Noah4730/Senior-Design/Design Package/Schematics/Arduino Mega 2560 Pinout Projects & Spec_External.png

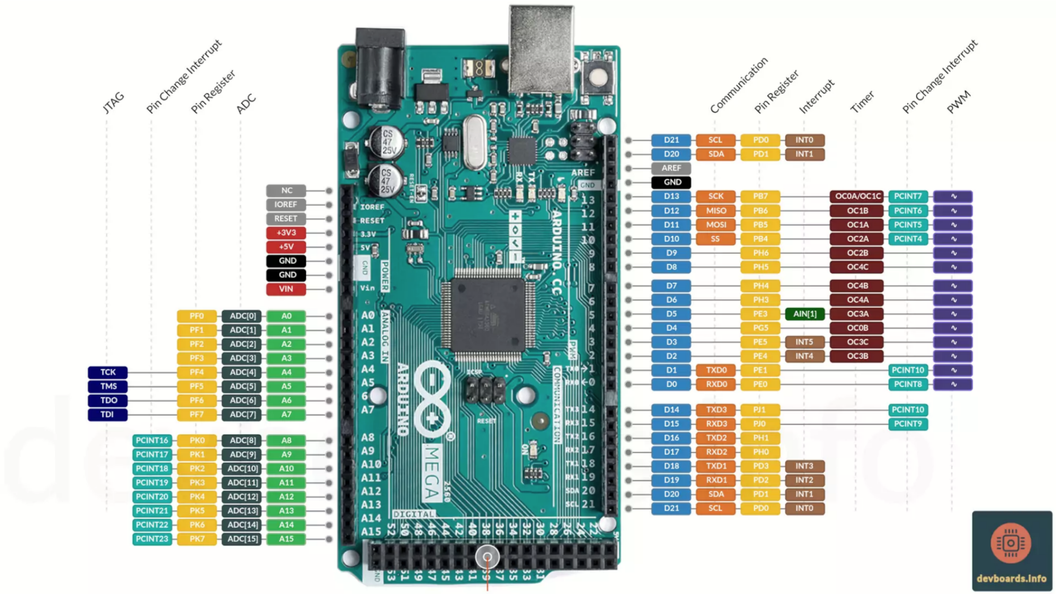
Design Package/Schematics/Arduino Mega 2560 Pinout Projects & Spec_External.png
