Noah4730/Senior-Design/Design Package/Schematics/Optocoupler Image_External.jpg

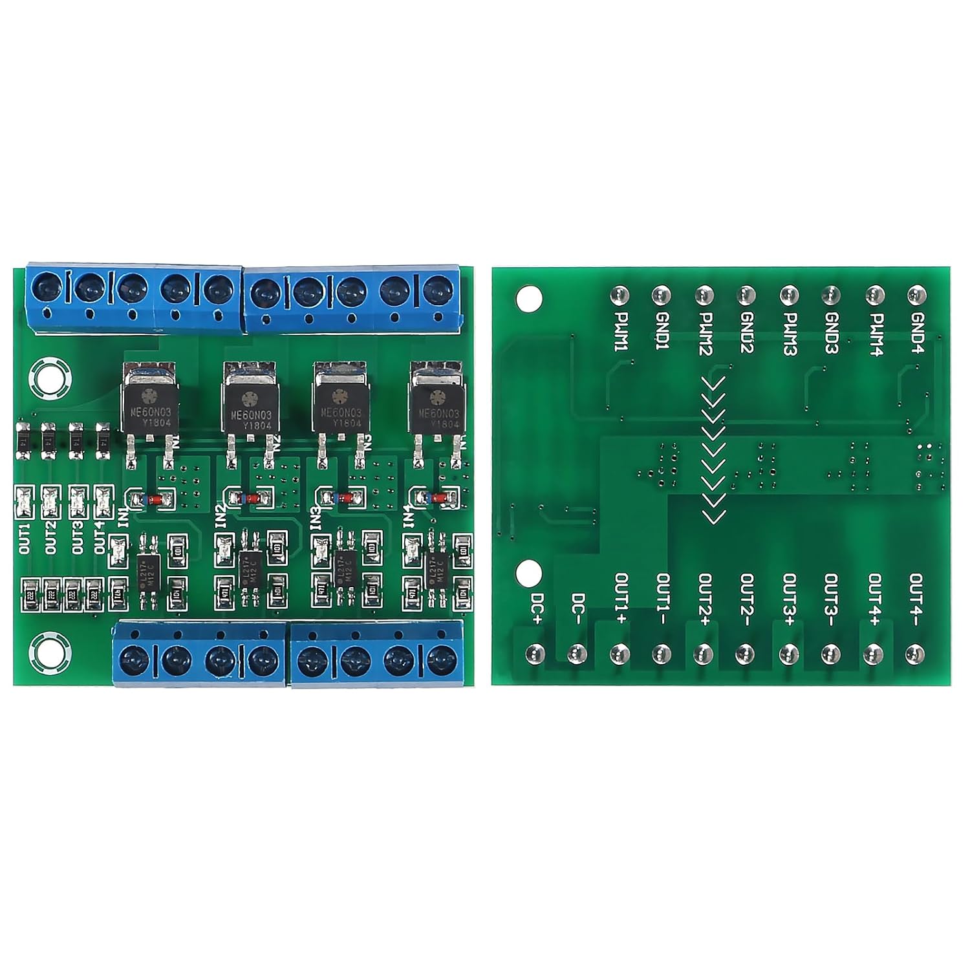
Design Package/Schematics/Optocoupler Image_External.jpg
