Noah4730/Senior-Design/README.md

# Senior-Design
This Github project contains the progress on the Zeus Project. As of May 2026, the team has created a concept demo of how the device will function as proof of concept and find any problems we might have while making the prototype.
