Noah4730/Senior-Design/Misc LRAD info/YouTube Links of stuff I found.docx

YouTube Links of stuff I found

This guy created a DIY LRAD device and… it’s very large to say the least. He has some files in the description:

https://youtu.be/y7UZHEHhdek (https://youtu.be/y7UZHEHhdek?si=uDVMpo0iQYFFn_xV)

The same guy is showing how to defend yourself against them:

https://youtu.be/Lg_aUOSLuRo (https://youtu.be/Lg_aUOSLuRo?si=JcSFuqxDgXy68F-K)

A YouTube short of this guy who made an LRAD out of stuff from Walmart:

https://youtu.be/MhGSYTc4Fus (https://youtu.be/MhGSYTc4Fus?si=M1YSCUhVt2ILN-A1)
