Noah4730/Senior-Design/Design Package/CAD Drawings/Self_Defense_Device_lights_DC.pdf

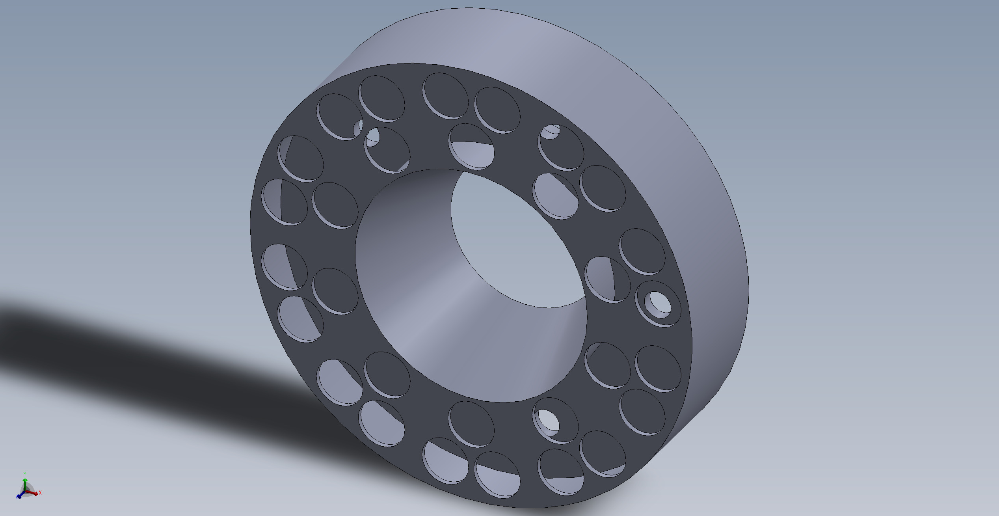
[picture p34: page 1]
