Noah4730/Senior-Design/Design Package/CAD Drawings/Concept Drawing 2_NJS.jpg

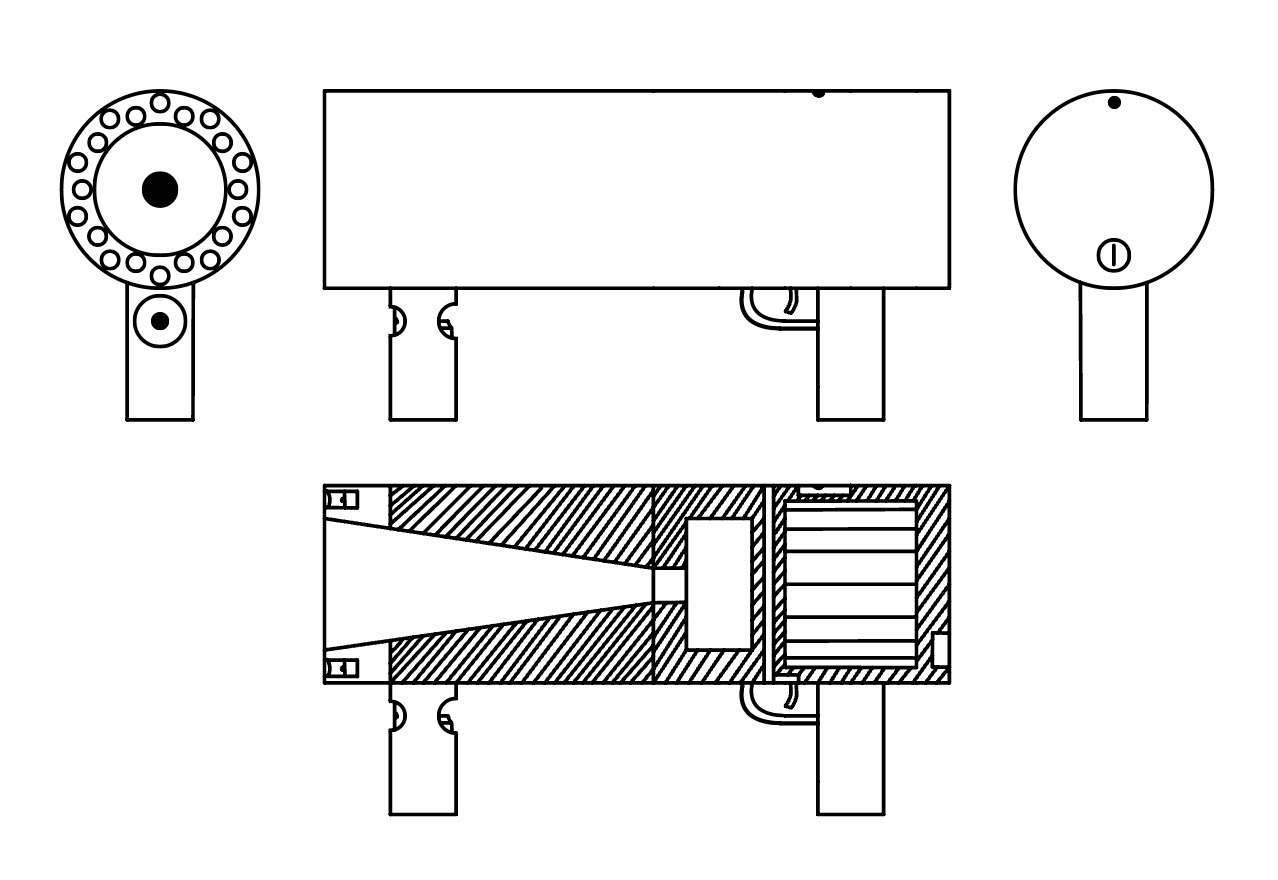
Design Package/CAD Drawings/Concept Drawing 2_NJS.jpg
