Noah4730/Senior-Design/Design Package/Schematics/LED Sim Draft_JA.png

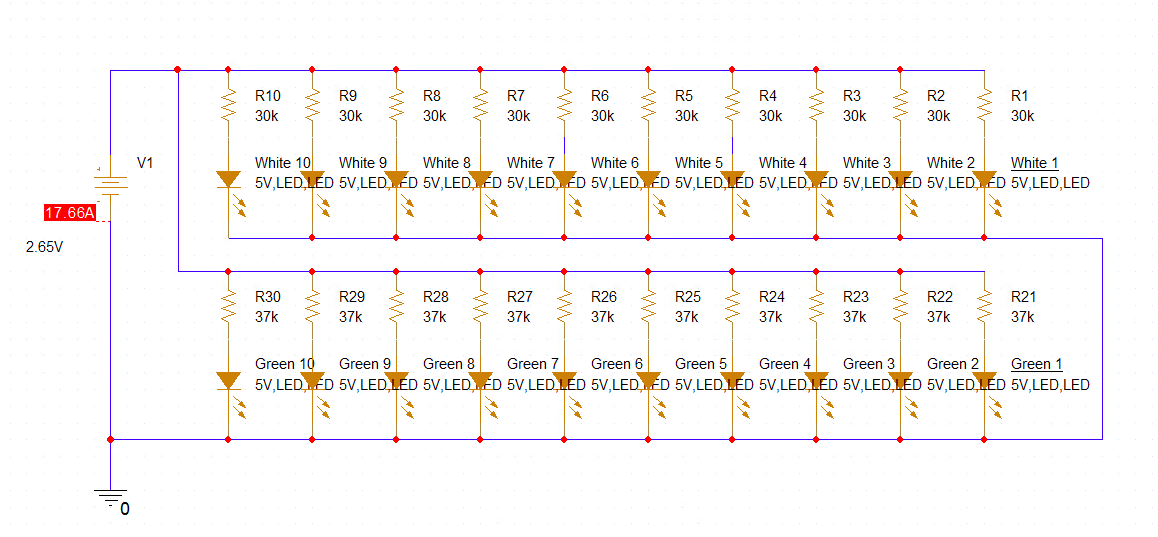
Design Package/Schematics/LED Sim Draft_JA.png
