Noah4730/Senior-Design/Design Package/Schematics/Optocoupler Pinout_External.jpg

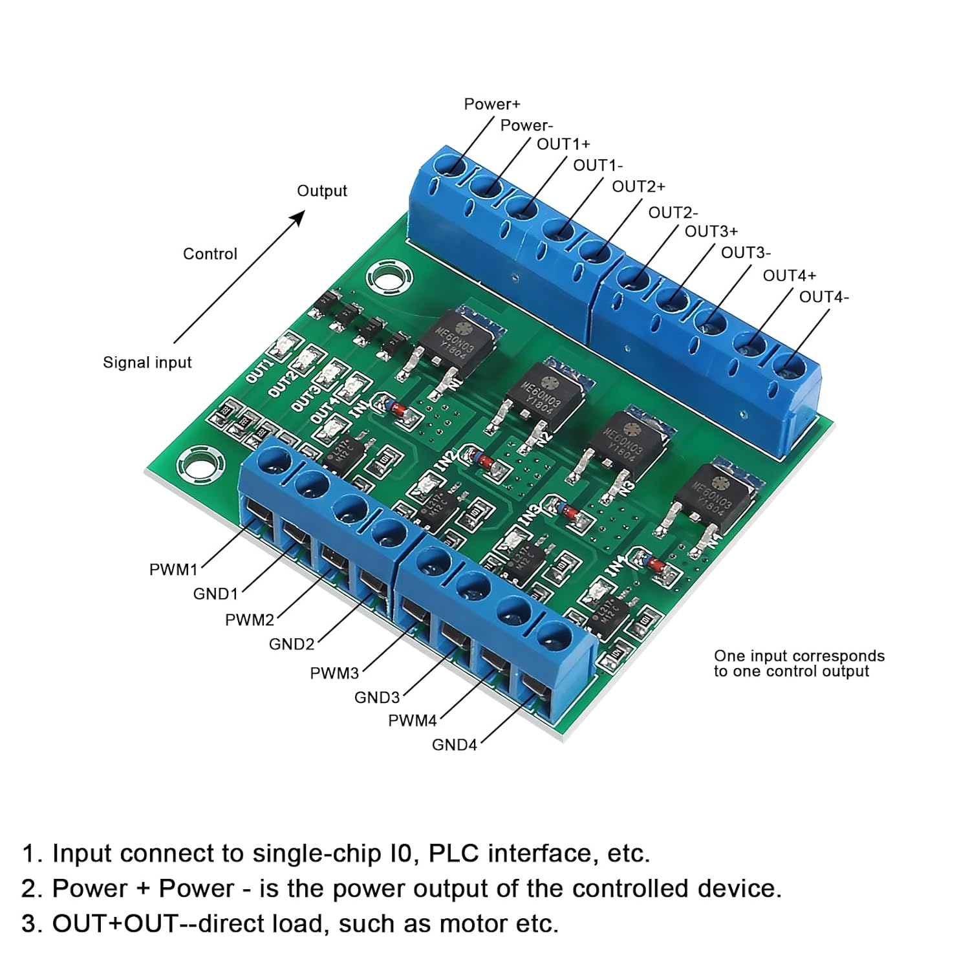
Design Package/Schematics/Optocoupler Pinout_External.jpg
