Noah4730/Senior-Design/Hardware Diagram.png

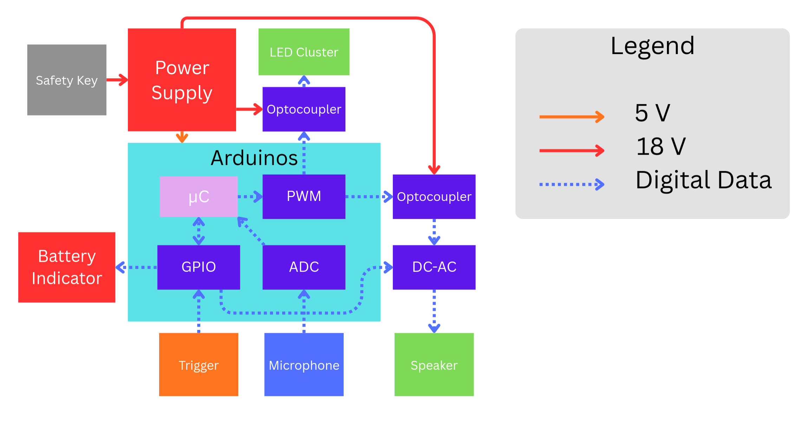
Hardware Diagram.png
