Noah4730/Senior-Design/Senior Design Project_JA.gif

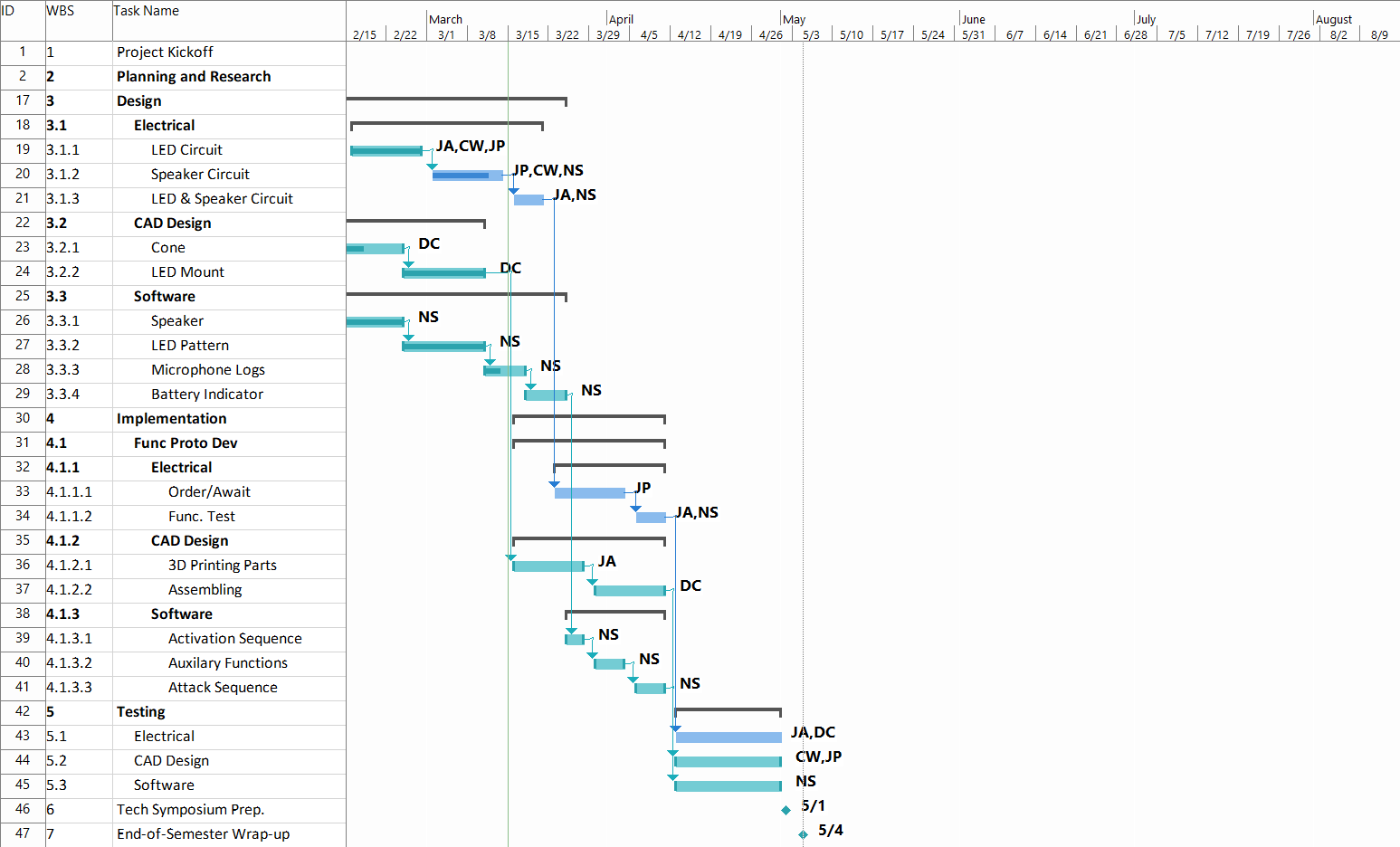
Senior Design Project_JA.gif
