Noah4730/Senior-Design/Design Package/Components/Working Project Inventory_JP.xlsx

Item Name | Manufacturer | Model No. | pkgs | amt in pkg | Notes | Provided by | Column 8
Green LED Star | CREEXPE2-GRN or ce20grnr3 | g20-s4 2551 | 1 | 10 | $10, total 102.80 or 20 of them grw1 | Bret | We actually use
"" Cool White XLAMP Cree XML2 | CREEXML2-W318 | ido-u3 2602 | 2 | 8 | 2pkgs ,8 $10.58 total 96.99, 10 119.89 | Bret | We actually use
LED Lens 5 degree | - | - | 1 | 10 | 20mm High Power | Bret | We actually use
LED Lens 15 degree | - | - | 1 | 10 | 20mm High Power | Bret | We actually use
Lens 5 degree | - | - | 1 | 10 | 20mm High Power Clear | Bret | We actually use
LED Convex Lens | - | - | 1 | 20 | Lamp Beads | Bret | We actually use
Speaker | DS18Pro | Pro-DRNSC1.5 |  |  | 1.5" polymide Voice Coil Screw 320W peak power , driver w neodymium magnet , throat 1"/25.4mm we like it loud | Bret | We actually use
Electrical Wire | Haerkn | - | 3 | 1 | - | Bret | We actually use
ESP32 WROOM Dev Board | AiTrip | 15363 | 1 | 1 | 300 pin | Ourselves | We actually use
DC Step Up Converter | KTOPTENG | I0015-A149 | 1 | 1 | 12/24V-36V 6A 216W Step Up Car Power Supply Converter Regulator Waterproof | Ourselves | We actually use
Light-dimming Film | - | - |  |  | Protect eyes from LEDs | Professors | We actually use
Lumen Meter | - | - |  |  | Measure light output | Professors | We actually use
2.5x10mm Metal Inserts | - | - | 1 | 10 | Use as connectors for device | Professors | We actually use
Rectifier Diode | Bojack | IN5408 | 1 | 50 | BJ-08 V(RRM) 1kV I(AV) 3A | Bret | We do not use
Midrange/Tweeter Compression Driver | Pyle USA | PDS122 | 2 | 1 | 250W 1.4" 35mm Flat Aluminum Voice Coil 1.5k-20kHz, | Bret | We do not use
LED Flasher Fn | Everbright |  | 4 | 4 | - | Bret | We do not use
Sound Level Meter dB | Durfiost | SL720C | 1 | 1 | - | Bret | We do not use
Car Relay | - | JD2912 | 2 | 2 | 12V 4Pin 20A ...an Motorcycle, boat 40A 14VDC 86 87 30 | Bret | We do not use
DMWD Metal Halo Ring | - | - | 5 | 5 | 12mm Metal ..th Halo Ring Blue LED | Bret | We do not use
Self-Fusing Silicone Tape | Proxicast | ANT-900-002 | 1 | 1 | Pro-Grade Great for Sealing COAX Connectors 1.5inx30milx15ft | Bret | We do not use
Dual Sided M-F HEader Connector | Sunxeke | - | 2 | 2 | 17 Values Double Sided | Bret | We do not use
Mini fan | - | A251012M |  |  | sleere bearing DC12v 0.06A | Bret | We do not use
Voltage Regulator Assortment Kit | Bojack | - | 1 | 50 | 10 values 50pcs LM317T...L7824 | Bret | We do not use
Laser Scope | feyachi | - |  |  | Laser Sight Module armed forces | Bret | We do not use
trigger switches | nilight | - | 1 | 6 | - | Bret | We do not use
Mace Pepper gel | - | Magnum 3 |  |  | Distance defense 10% oc pepper invisible uvdye gel stream | Bret | We do not use
Low Thermal Resistence Adhesive | Arctic Silver | ASTA-20G | 1 | 1 | Reach/rohs compliant, luxeonstar.com/asta-20g, Quick cure silver epoxy permanent thermal adhesive | Bret | We do not use
WigWagger Alternating Flasher | Stop Alert | - | 2 | 1 | 72, 36wx2/12-24V | Bret | We do not use
55 Lithium Battery Board 20A | - | - | 1 | 1 | - | Bret | We do not use
Step Down Module | HiLetgo, Shenzehenshi | - | 1 | 1 | 5A 75W DC-DC Step down module | Bret | We do not use
Metal Universal Driver Speaker | Speco technologies | SRD100 | 1 | 1 | 100W RMS 16Ohm VC 1-3/8"x18TPI Throat | Bret | We do not use
Cooling Fan | GDSTIME | - | 2 | 2 | 2pk 80mmx25mm Dual Ball Bearings High Speed 4500RPM 12VDC Brushless COoling Fan | Bret | We do not use
Motorcycle Voltage Monitor | Exqutoo | - | 1 | 2 | DC 0-100V | Bret | We do not use
Battery Packs (Drones) | R-Line | - | 3 | 1 | Tattu Lipo R-Line3.0 1550mAh 120C 5 cells 18.5V 28.6Wh | Bret | We do not use
Smart Charger | Lipo | 608PD | 1 | 1 | ISD Link, PD 3.1 DC input 240w, USBc input 140W isdt.co | Bret | We do not use
Silicone PVC Wire | TUOFENG | - | 3 | 1 | 22AWG 100ft 2pin 1pack | Bret | We do not use
Lipo Battery Voltage Tester | CAMWAY | CAM001s | 1 | 1 | 5pcs 2 in 1 1-8s Lipo/Li-ion/LiMn/LiFe | Bret | We do not use
Power Amplifier | HiLetgo | TPA3116 | 1 | 1 | 2pcs | Bret | We do not use
