Noah4730/Senior-Design/Design Package/CAD Drawings/Light_Assembly_V2_DC.SLDPRT

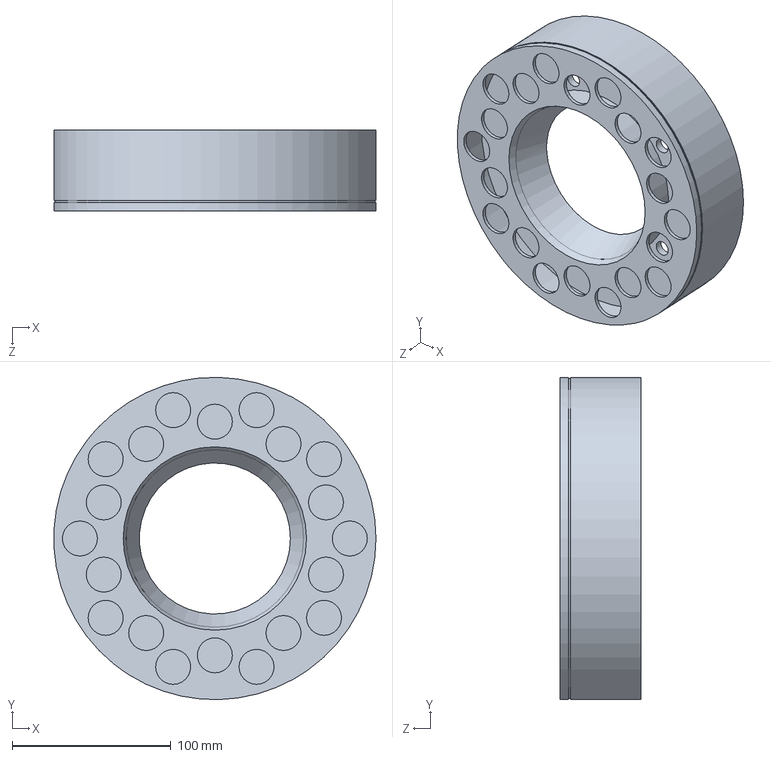
[picture p42: CAD file, 2026-09-04]
Design Package/CAD Drawings/Light_Assembly_V2_DC.SLDPRT
203.0 x 203.1 x 50.8 mm
