Noah4730/Senior-Design/Design Package/CAD Drawings/BodyDeviceTemp.stl

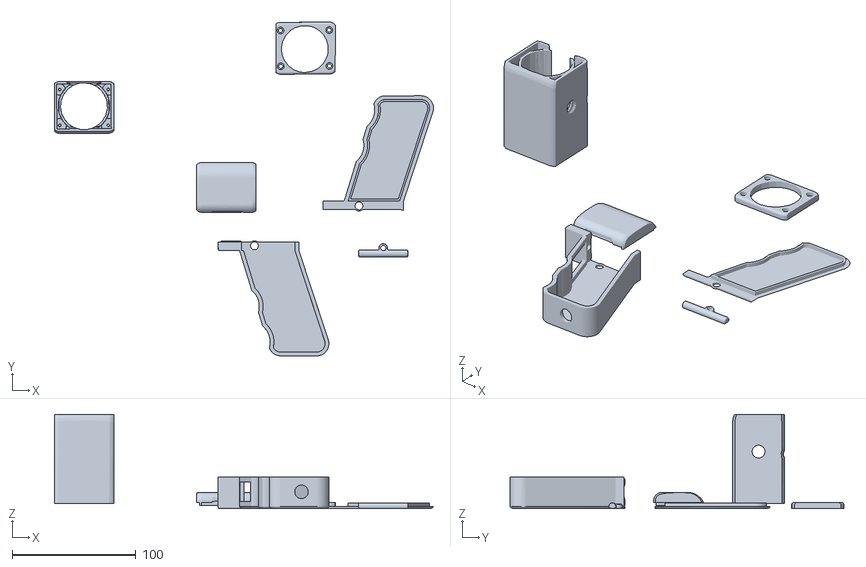
[picture p43: CAD file, 2026-09-25]
Design Package/CAD Drawings/BodyDeviceTemp.stl
306.1 x 269.7 x 76.0
