Noah4730/Senior-Design/LED_BACK_FINAL.SLDPRT

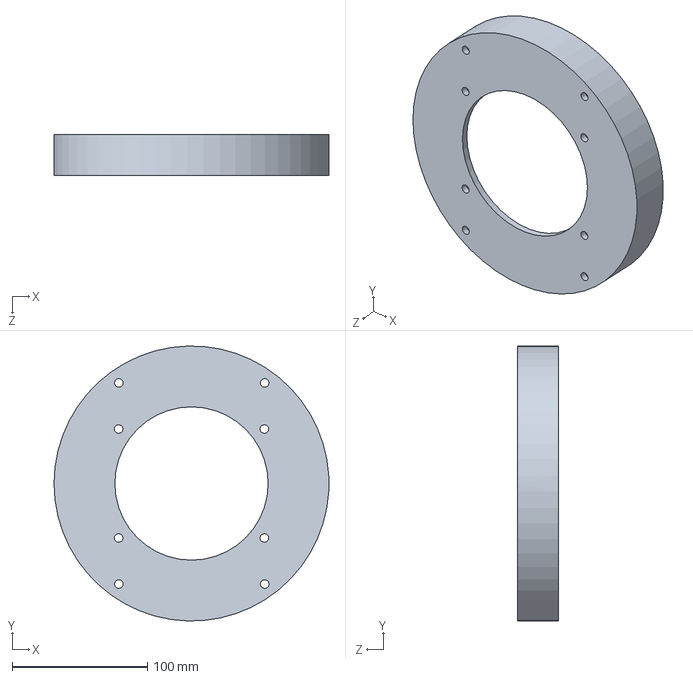
[picture p44: CAD file, 2026-11-02]
LED_BACK_FINAL.SLDPRT
203.2 x 203.1 x 30.5 mm
