Noah4730/Senior-Design/Design Package/CAD Drawings/Cone_V2_DC.SLDPRT

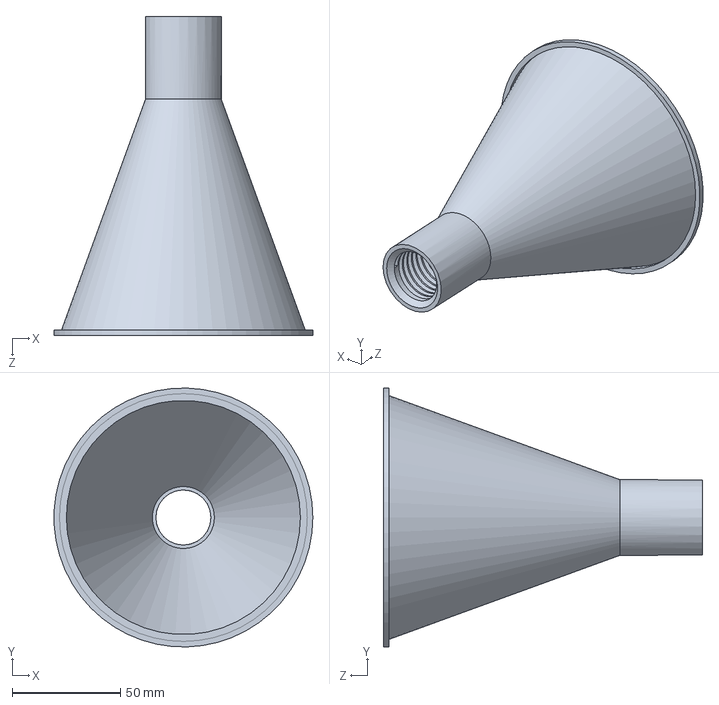
[picture p45: CAD file, 2026-09-10]
Design Package/CAD Drawings/Cone_V2_DC.SLDPRT
119.3 x 119.3 x 147.1 mm
