Noah4730/Senior-Design/LED_FACE_FINAL.SLDPRT

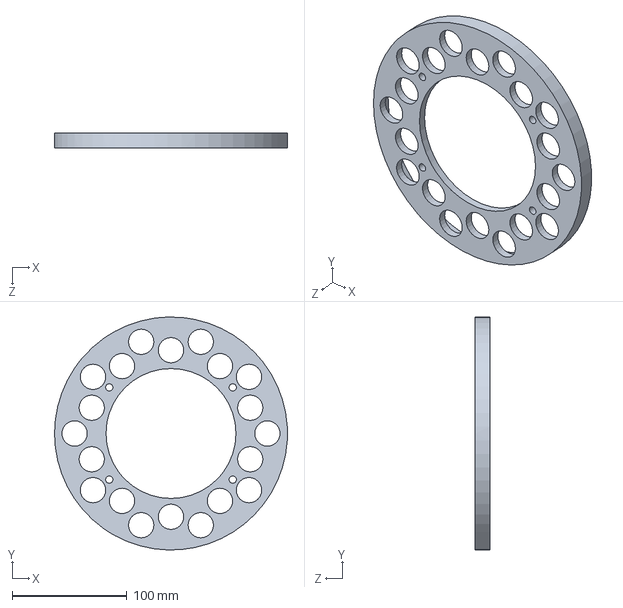
[picture p46: CAD file, 2026-11-02]
LED_FACE_FINAL.SLDPRT
203.2 x 203.1 x 12.7 mm
