Noah4730/Senior-Design/Cone_FINAL.SLDPRT

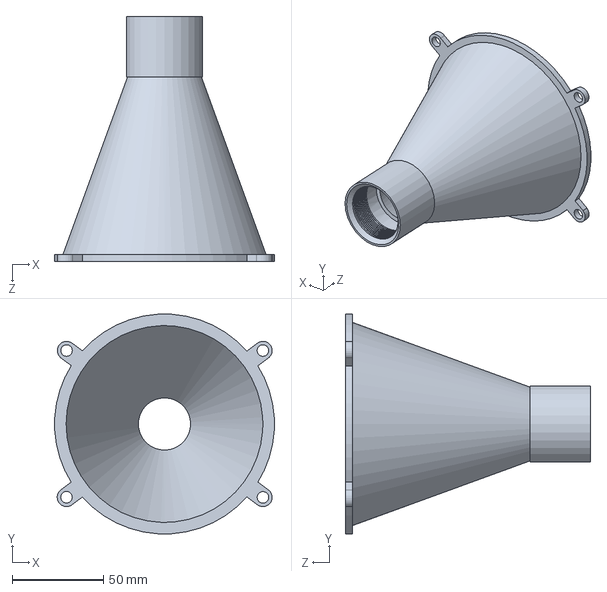
[picture p47: CAD file, 2026-11-02]
Cone_FINAL.SLDPRT
120.6 x 120.6 x 134.4 mm
