Noah4730/Senior-Design/Design Package/CAD Drawings/Self_Defense_Device_lights_DC.SLDPRT

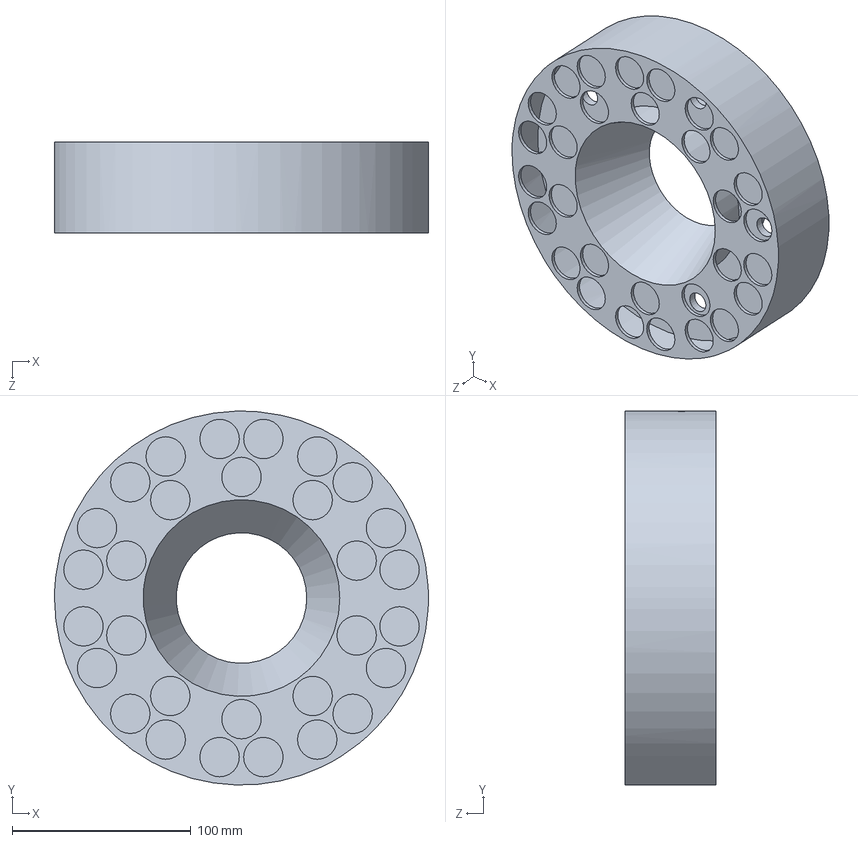
[picture p48: CAD file, 2026-09-04]
Design Package/CAD Drawings/Self_Defense_Device_lights_DC.SLDPRT
209.2 x 209.2 x 50.8 mm
