Noah4730/Senior-Design/(list of files, cad)

Other CAD files:
Design Package/CAD Drawings/Cone_V1_DC.SLDPRT
CONE_V3_DIMENSION1.SLDDRW
CONE_V3_DIMENSION2.SLDDRW
LED_BACKDIMENSION1.SLDDRW
LED_BACKDIMENSION2.SLDDRW
LED_FACEDIMENSION2.SLDDRW
LED_FACE_DIMENSION1.SLDDRW
