Noah4730/Senior-Design/Test Spreadsheets/TestCases_JP.xlsx

Sheet: Template_1.1
Project Name |  | Project Zeus |  | Module Name |  | Integration Verification
Created By |  | Jessy Pena |  | Created Date |  | 2026-10-02
Executed By |  |  |  | Execution Date
Reviewed By |  |  |  | Reviewed Date
Test Scenario ID |  | ITV_001
Test Scenario Description |  | Test trigger activates and deactivates device properly and immediately
Test Case ID |  | ITV_Trigger_001
Test Case Description |  | User pulls trigger to its full extent, and releases fully
Test Case Results |  | (Pass/Fail/Not executed/Suspended/Further Review)
 | Prerequisites |  |  |  | Test Data
1 | Device needs to have all components connected |  |  | 1 | Pull trigger completely and hold for 10 seconds continuously
2 | User must be able to wield device and pull/release trigger |  |  | 2 | Release trigger fully after 10s
3 | User must be wearing hearing PPE |  |  | 3
4 |  |  |  | 4
Step # | Step Details |  | Expected Results |  |  | Actual Results | Status
1 | Hold device similar to a gun, hand on grip and finger off trigger |  | No sound or lights should be on
2 | Insert & turn safety key to on position |  | Activates safety light
3 | Press trigger fully down and hold for 10s |  | Sound and light should occur, in expected, randomized intervals
4 | Release trigger fully after 10s |  | Sound and light should cease, and safety light should reactivate
5
6
7
8
9
10
11

Sheet: Template_1.2
Project Name |  | Zeus |  | Module Name |  | Integration Verification
Created By |  | Jessy Pena |  | Created Date |  | 2026-10-02
Executed By |  |  |  | Execution Date
Reviewed By |  |  |  | Reviewed Date
Test Scenario ID |  | ITV_001
Test Scenario Description |  | Test trigger activates and deactivates device properly and immediately
Test Case ID |  | ITV_Trigger_002
Test Case Description |  | User pulls trigger to its full extent, and releases halfway
Test Case Results |  | (Pass/Fail/Not executed/Suspended/Further Review)
 | Prerequisites |  |  |  | Test Data
1 | Device needs to have all components connected |  |  | 1 | Pull trigger completely and hold for 10 seconds continuously
2 | User must be able to wield device and pull/release trigger |  |  | 2 | Release trigger to half position after 10s
3 | User must be wearing hearing PPE |  |  | 3
4 |  |  |  | 4
Step # | Step Details |  | Expected Results |  |  | Actual Results | Status
1 | Hold device similar to a gun, hand on grip and finger off trigger |  | No sound or lights should be on
2 | Insert & turn safety key to on position |  | Activates safety light
3 | Press trigger fully down and hold 10s |  | Sound and light should occur, in expected, randomized intervals
4 | Release trigger to halfway position |  | Sound and light should cease, and safety light should reactivate
5
6
7
8
9
10
11

Sheet: Template_1.3
Project Name |  | Zeus |  | Module Name |  | Integration Verification
Created By |  | Jessy Pena |  | Created Date |  | 2026-10-02
Executed By |  |  |  | Execution Date
Reviewed By |  |  |  | Reviewed Date
Test Scenario ID |  | ITV_001
Test Scenario Description |  | Test trigger activates and deactivates device properly and immediately
Test Case ID |  | ITV_Trigger_003
Test Case Description |  | User pulls trigger halfway, and releases fully
Test Case Results |  | (Pass/Fail/Not executed/Suspended/Further Review)
 | Prerequisites |  |  |  | Test Data
1 | Device needs to have all components connected |  |  | 1 | Pull trigger to halfway position and hold for 10 seconds continuously
2 | User must be able to wield device and pull/release trigger |  |  | 2 | Release trigger fully after 10s
3 | User must be wearing hearing PPE |  |  | 3
4 |  |  |  | 4
Step # | Step Details |  | Expected Results |  |  | Actual Results | Status
1 | Hold device similar to a gun, hand on grip and finger off trigger |  | No sound or lights should be on
2 | Insert & turn safety key to on position |  | Activates safety light
3 | Press trigger halfway and hold for 10s |  | Sound and light should not occur, safety light should still be on
4 | Release trigger fully |  | Sound and light should not occur, safety light should still be on
5
6
7
8
9
10
11

Sheet: Template_2.1
Project Name |  | Zeus |  | Module Name |  | Integration Verification
Created By |  | Jessy Pena |  | Created Date |  | 2026-10-02
Executed By |  |  |  | Execution Date
Reviewed By |  |  |  | Reviewed Date
Test Scenario ID |  | ITV_003
Test Scenario Description |  | Verifies safety key enables and disables trigger function
Test Case ID |  | ITV_SafetyKey_001
Test Case Description |  | User turns safety key to on position and pulls trigger completely
Test Case Results |  | (Pass/Fail/Not executed/Suspended/Further Review)
 | Prerequisites |  |  |  | Test Data
1 | Device needs to have all components connected |  |  | 1 | User inserts key and turns to on position
2 | User must be able to wield device and pull/release trigger |  |  | 2
3 | User must be wearing hearing PPE |  |  | 3
4 | User must have key to insert |  |  | 4
Step # | Step Details |  | Expected Results |  |  | Actual Results | Status
1 | Hold device similar to a gun, hand on grip and finger off trigger |  | No sound or lights should be on
2 | Insert & turn safety key to on position |  | Safety light should be active, power should be on
3 | Press trigger fully down and release after 10s |  | Sound and light should occur, in expected, randomized intervals, then end immediately after release
4
5
6
7
8
9
10
11

Sheet: Template_2.2
Project Name |  | Zeus |  | Module Name |  | Integration Verification
Created By |  | Jessy Pena |  | Created Date |  | 2026-10-02
Executed By |  |  |  | Execution Date
Reviewed By |  |  |  | Reviewed Date
Test Scenario ID |  | ITV_003
Test Scenario Description |  | Verifies safety key enables and disables trigger function
Test Case ID |  | ITV_SafetyKey_002
Test Case Description |  | User does not turn safety key to on position and pulls trigger completely
Test Case Results |  | (Pass/Fail/Not executed/Suspended/Further Review)
 | Prerequisites |  |  |  | Test Data
1 | Device needs to have all components connected |  |  | 1 | User inserts key but does not turn on
2 | User must be able to wield device and pull/release trigger |  |  | 2 | User pulls trigger fully and releases after 10s
3 | User must be wearing hearing PPE |  |  | 3
4 | User must have key to insert |  |  | 4
Step # | Step Details |  | Expected Results |  |  | Actual Results | Status
1 | Hold device similar to a gun, hand on grip and finger off trigger |  | No sound or lights should be on
2 | Insert safety key but do not turn on |  | No sound or lights should be on, all power still off
3 | Press trigger fully down and release after 10s |  | Sound and light should still be off, with no change from previous actions
4
5
6
7
8
9
10
11

Sheet: Template_3.1
Project Name |  | Zeus Project |  | Module Name |  | Integration Verification
Created By |  | Jessy Pena |  | Created Date |  | 2026-10-02
Executed By |  |  |  | Execution Date
Reviewed By |  |  |  | Reviewed Date
Test Scenario ID |  | SLV_007
Test Scenario Description |  | Verifies battery indicator displays accurate charge and low battery warning
Test Case ID |  | SLV_BatteryInd_001
Test Case Description |  | Battery is fully charged
Test Case Results |  | (Pass/Fail/Not executed/Suspended/Further Review)
 | Prerequisites |  |  |  | Test Data
1 | Battery, monitoring circuit, microcontroller with software, indicator are needed to be connected properly |  |  | 1 | Power on, battery at certain voltage
2 | Multimeter to measure voltage |  |  | 2
3 |  |  |  | 3
4 |  |  |  | 4
Step # | Step Details |  | Expected Results |  |  | Actual Results | Status
1 | Connect all components according to schematic |  | Power should be flowing, battery indicator should not be on
2 | Press on button of microcontroller |  | Battery indicator should be on and displaying a full charge battery, no warning
3 | Connect multimeter in parallel with battery |  | Multimeter should display the voltage the battery is outputting
4 | Connect multimeter in parallel with battery indicator |  | Multimeter should display the voltage the battery is outputting
5
6
7
8
9
10
11

Sheet: Template_3.2
Project Name |  | Zeus Project |  | Module Name |  | Integration Verification
Created By |  | Jessy Pena |  | Created Date |  | 2026-10-02
Executed By |  |  |  | Execution Date
Reviewed By |  |  |  | Reviewed Date
Test Scenario ID |  | SLV_007
Test Scenario Description |  | Verifies battery indicator displays accurate charge and low battery warning
Test Case ID |  | SLV_BatteryInd_002
Test Case Description |  | Battery is at 20% or less
Test Case Results |  | (Pass/Fail/Not executed/Suspended/Further Review)
 | Prerequisites |  |  |  | Test Data
1 | Battery, monitoring circuit, microcontroller with software, indicator are needed to be connected properly |  |  | 1 | Power on, battery at certain voltage
2 | Multimeter to measure voltage |  |  | 2
3 |  |  |  | 3
4 |  |  |  | 4
Step # | Step Details |  | Expected Results |  |  | Actual Results | Status
1 | Connect all components according to schematic |  | Power should be flowing, battery indicator should not be on
2 | Press on button of microcontroller |  | Battery indicator should be on and displaying a low-battery warning
3 | Connect multimeter in parallel with battery |  | Multimeter should display the voltage the battery is outputting (≤20%)
4 | Connect multimeter in parallel with battery indicator |  | Multimeter should display the voltage the battery is outputting (≤20%)
5
6
7
8
9
10
11

Sheet: ExampleA
Project Name |  | mySoftwareProject |  | Module Name |  | myLogin
Created By |  | Johnathan Votion |  | Created Date |  | 2022-09-09
Executed By |  | TeamMember |  | Execution Date |  | ThisDate
Reviewed By |  |  |  | Reviewed Date
Test Scenario ID |  | TS_MLG_001
Test Scenario Description |  | Test user login credentials and verify functionality
Test Case ID |  | TC_MLG_Login_001
Test Case Description |  | User enters valid user name and valid password
Test Case Results |  | (Pass/Fail/Not executed/Suspended/Further Review)
 | Prerequisites |  |  |  | Test Data
1 | System needs to have test data registered into the system/network. |  |  | 1 | Username: myname@gmail.com
2 | There needs to be an available URL. Dafsafaasf |  |  | 2 | password: xxxxx
3 | URL w/ username and password fields. |  |  | 3
4 | URL w/ login button. |  |  | 4
Step # | Step Details |  | Expected Results |  |  | Actual Results | Status
1 | Enter username information into username field |  | Username information appears in username field. |  |  | As Expected | Pass
2 | Enter password information into password field |  | Password information appears in password field as asterisks or black dots. |  |  | Password field does not mask password characters | Fail
3 | Click on the login button |  | Browser advances to homepage |  |  | As Expected | Pass
4
5
6
7
8
9
10

Sheet: ExampleB
Project Name |  | Zeus |  | Module Name |  | myLogin
Created By |  | Johnathan Votion |  | Created Date |  | 2022-09-09
Executed By |  | TeamMember |  | Execution Date |  | ThisDate
Reviewed By |  |  |  | Reviewed Date
Test Scenario ID |  | TS_MLG_001
Test Scenario Description |  | Test User login credentials and verify functionality
Test Case ID |  | TC_MLG_Login_002
Test Case Description |  | Enter valid user name and invalid password
Test Case Results |  | (Pass/Fail/Not executed/Suspended/Further Review)
 | Prerequisites |  |  |  | Test Data
1 | System needs to have test data registered into the sytstem/network. |  |  | 1 | Username: myname@gmail.com
2 | There needs to be an available URL. Dafsafaasf |  |  | 2 | password: yyyyyyy
3 |  |  |  | 3
4 |  |  |  | 4
Step # | Step Details |  | Expected Results |  |  | Actual Results | Status
1 | Enter username information into username field |  | Username information appears in username field. |  |  | As Expected | Pass
2 | Enter password information into password field |  | Password information appears in password field as asterisks or black dots. |  |  | As Expected | Pass
3 | Click on the login button |  | Browser gives message "Incorrect Login" |  |  | Browser gives blank message | Fail
4
5
6
7
8
9
10
