Noah4730/Senior-Design/Test Spreadsheets/Test Cases_SVV-03_SLV-01-03_NJS.xlsx

Sheet: Template
Project Name |  |  |  | Module Name
Created By |  |  |  | Created Date
Executed By |  |  |  | Execution Date
Reviewed By |  |  |  | Reviewed Date
Test Scenario ID
Test Scenario Description
Test Case ID
Test Case Description
Test Case Results |  | (Pass/Fail/Not executed/Suspended/Further Review)
 | Prerequisites |  |  |  | Test Data
1 |  |  |  | 1
2 |  |  |  | 2
3 |  |  |  | 3
4 |  |  |  | 4
Step # | Step Details |  | Expected Results |  |  | Actual Results | Status
1
2
3
4
5
6
7
8
9
10
11

Sheet: SSV-03
Project Name |  | Self-Defense Device (Zeus) |  | Module Name |  | Subsystem Verification
Created By |  | Noah Schatz |  | Created Date |  | 2026-10-02
Executed By |  |  |  | Execution Date
Reviewed By |  |  |  | Reviewed Date
Test Scenario ID |  | SSV-03
Test Scenario Description |  | Microcontroller & MOSFET Test
Test Case ID |  | SSV-03
Test Case Description |  | Verify the functionality of the microcontroller and MOSFETs.
Test Case Results
 | Prerequisites |  |  |  | Test Data
1 | PCB must be assembled with all necessary components |  |  | 1 | PWM Outputs
2 | Test code must be created to test the functionality of the components |  |  | 2 | Test Recording Data
3 |  |  |  | 3
4 |  |  |  | 4
Step # | Step Details |  | Expected Results |  |  | Actual Results | Status
1 | Measure PWM outputs on all pins |  | PWM outputs from 0 – 5V on each pin
2 | Verify the microcontroller can read recorded data on each pin |  | Microcontroller is able to detect the recorded data and accurately represent the strength of the signal
3 | Verify the operating range of the MOSFETs |  | MOSFETs accurately output the desired results within established tolerances
4
5
6
7
8
9
10

Sheet: SLV-01
Project Name |  | Self-Defense Device (Zeus) |  | Module Name |  | System Level Validation
Created By |  | Noah Schatz |  | Created Date |  | 2026-10-02
Executed By |  |  |  | Execution Date
Reviewed By |  |  |  | Reviewed Date
Test Scenario ID |  | SLV-01
Test Scenario Description |  | Software Testing
Test Case ID |  | SLV-01
Test Case Description |  | Ensures the software meets all engineering requirements and all components are correctly routed
Test Case Results
 | Prerequisites |  |  |  | Test Data
1 | Software file completed |  |  | 1 | Low output software demo
2 | PCB with included MOSFETs |  |  | 2
3 |  |  |  | 3
4 |  |  |  | 4
Step # | Step Details |  | Expected Results |  |  | Actual Results | Status
1 | Run software demo at low output with all components connected |  | Demo operates as expected on the channels that are connected
2
3
4
5
6
7
8
9
10

Sheet: SLV-02
Project Name |  | Self-Defense Device (Zeus) |  | Module Name |  | System Level Validation
Created By |  | Noah Schatz |  | Created Date |  | 2026-10-02
Executed By |  |  |  | Execution Date
Reviewed By |  |  |  | Reviewed Date
Test Scenario ID |  | SLV-02
Test Scenario Description |  | Full System Activation Test
Test Case ID |  | SLV-02
Test Case Description |  | Ensures that the system accurately records and logs data during operation
Test Case Results
 | Prerequisites |  |  |  | Test Data
1 | Functioning peripherals connected and verified to be working |  |  | 1 | Functioning demo code at full output
2 | Logging code |  |  | 2
3 |  |  |  | 3
4 |  |  |  | 4
Step # | Step Details |  | Expected Results |  |  | Actual Results | Status
1 | Run the demo code at full and minimum output through the entire frequency range and verify the microphone can register entire range |  | Full range of frequency and volume recorded
2
3
4
5
6
7
8
9
10

Sheet: SLV-03
Project Name |  | Self-Defense Device (Zeus) |  | Module Name |  | System Level Validation
Created By |  | Noah Schatz |  | Created Date |  | 2026-10-02
Executed By |  |  |  | Execution Date
Reviewed By |  |  |  | Reviewed Date
Test Scenario ID |  | SLV-03
Test Scenario Description |  | Sound and Light Efficacy Evaluation
Test Case ID |  | SLV-03
Test Case Description |  | Verifies the efficacy of the existing algorithm according to the researched parameters for human hearing.
Test Case Results
 | Prerequisites |  |  |  | Test Data
1 | Complete combined code for testing |  |  | 1 | Test output levels
2 | Test bench code to record output and compare to researched values |  |  | 2 | Researched human reaction and perception statistics
3 |  |  |  | 3
4 |  |  |  | 4
Step # | Step Details |  | Expected Results |  |  | Actual Results | Status
1 | Run complete code to create output values for testing |  | Code runs as designed and outputs values as programmed
2 | Run test bench to combine data into graphical form in comparison to researched values |  | Output data falls within researched tolerances to create the desired effect
3
4
5
6
7
8
9
10
