Noah4730/Senior-Design/Light_Housing_Measurements_DC.pdf

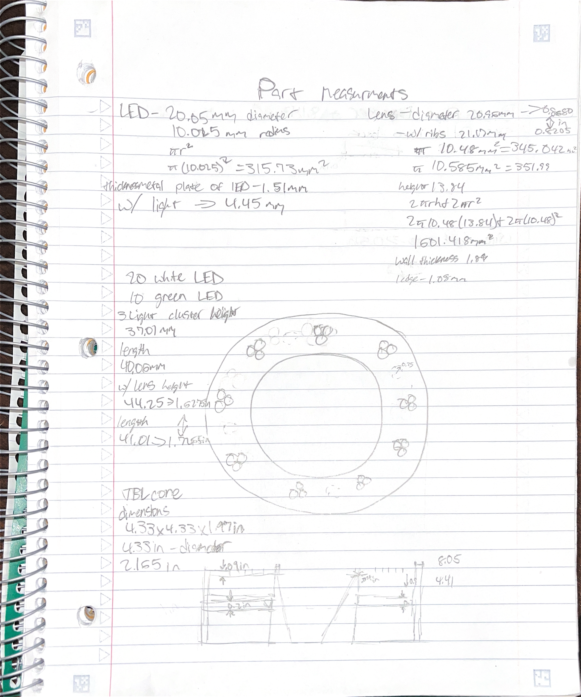
[picture p49: page 1]
