Noah4730/Senior-Design/Design Package/Schematics/Green LED testing_JA.PNG

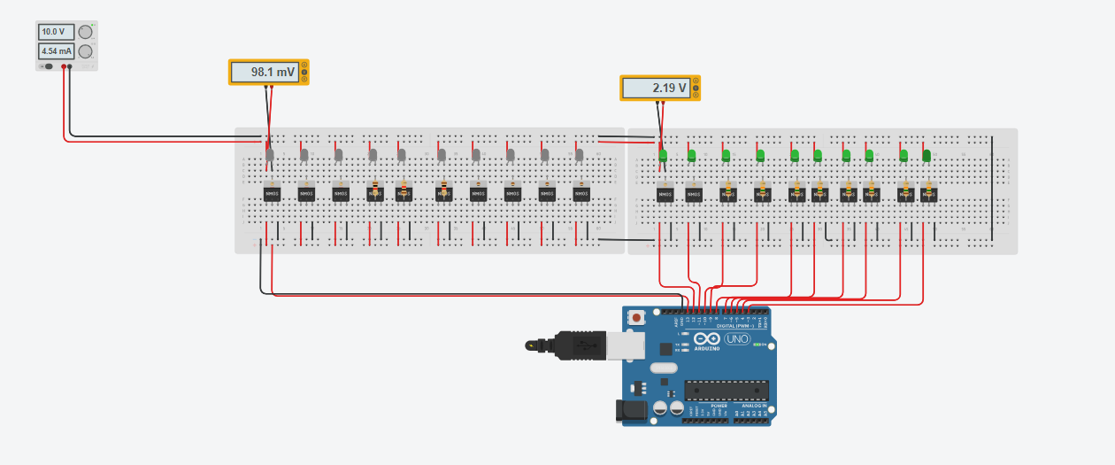
Design Package/Schematics/Green LED testing_JA.PNG
