Noah4730/Senior-Design/Design Package/Schematics/Zeus Project Schematics_V2_JA.pdf

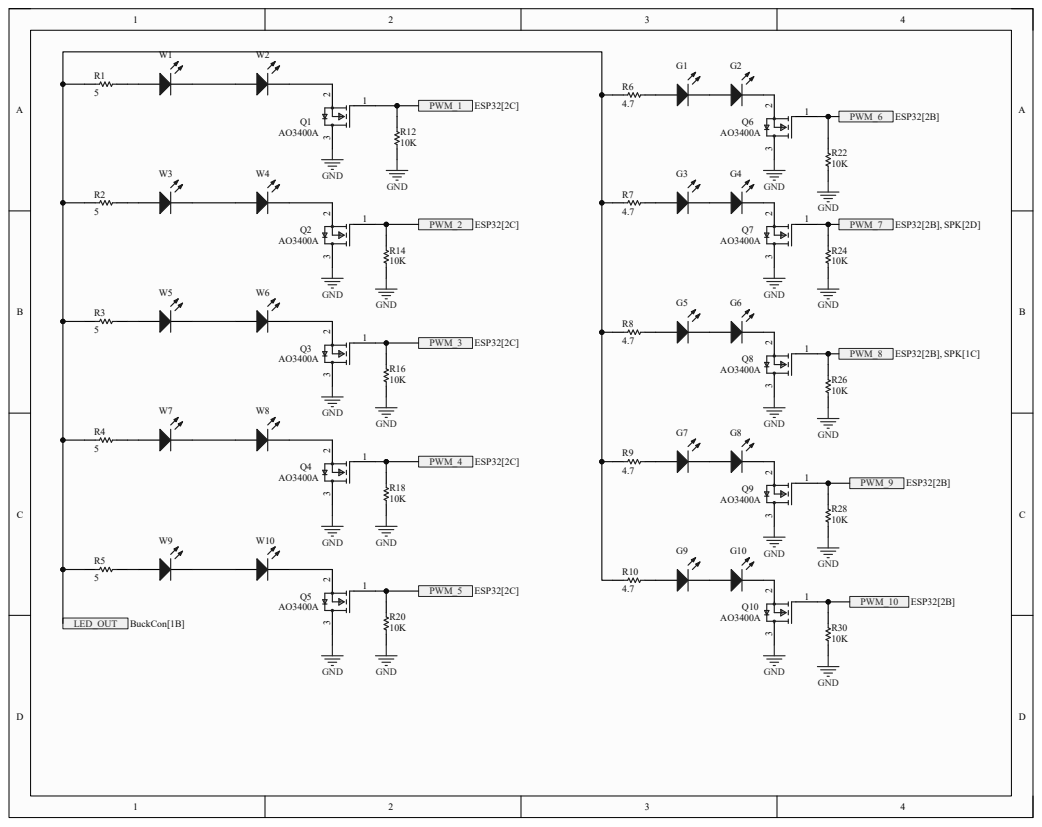
[picture p51: page 1]

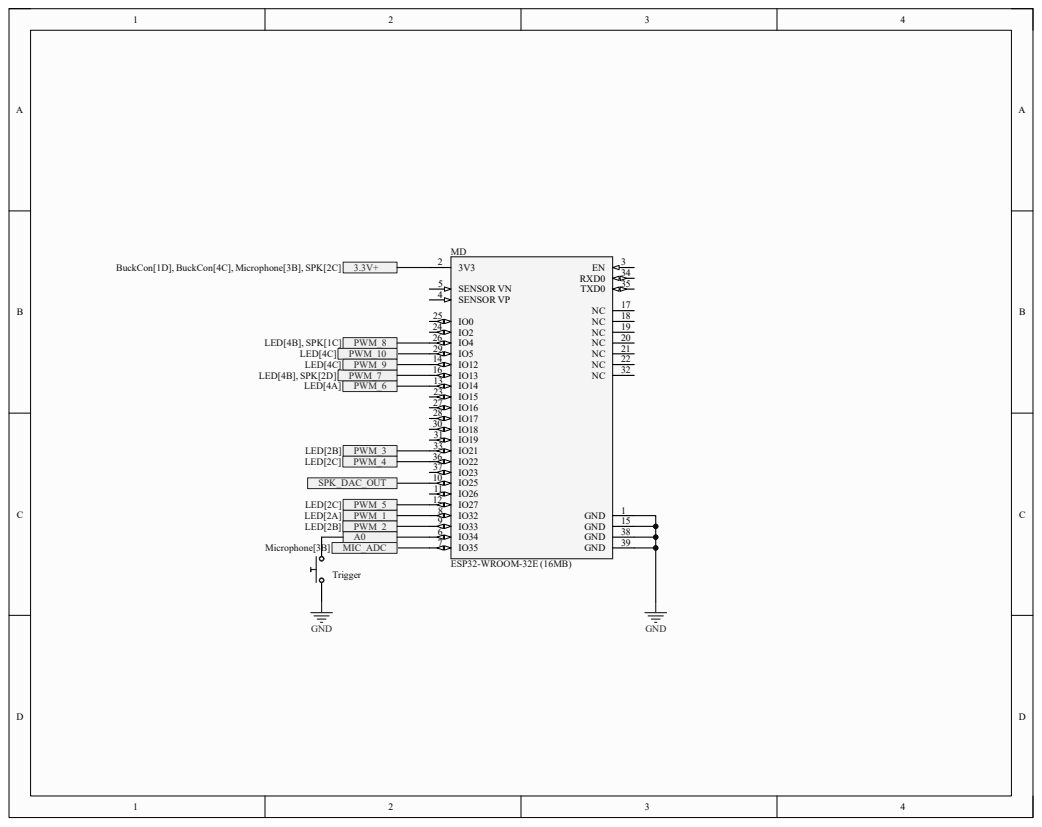
[picture p52: page 2]
SENSOR VN 5 SENSOR VP 4; RXD0; TXD0; GND; ESP32-WROOM-32E (16MB); LED[2A] PWM_1 LED[2B] PWM_2; LED[2B] PWM_3 LED[2C] PWM_4; LED[2C] PWM_5; LED[4A] PWM_6; LED[4B], SPK[2D] PWM_7; LED[4B], SPK[1C] PWM_8; Trigger; SPK_DAC_OUT; Microphone[3B] MIC_ADC; LED[4C] PWM_10 LED[4C] PWM_9

BuckCon[1D], BuckCon[4C], Microphone[3B], SPK[2C] 3.3V+

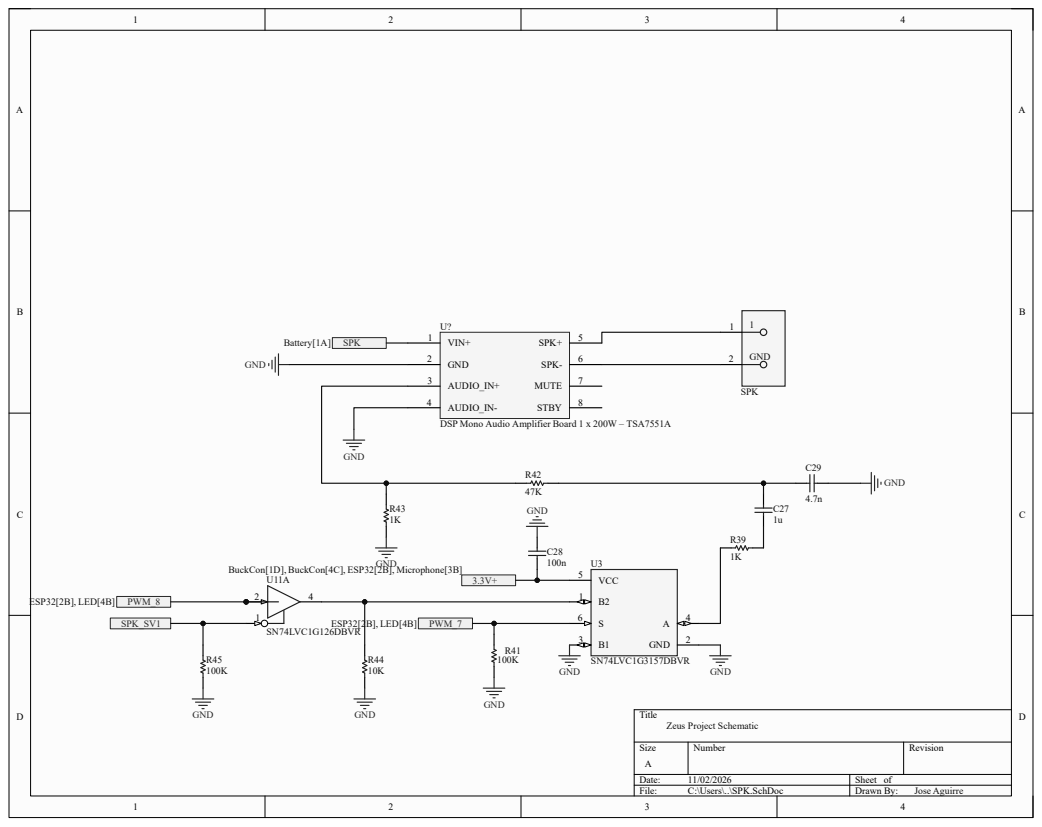
[picture p53: page 3]

DSP Mono Audio Amplifier Board 1 x 200W – TSA7551A

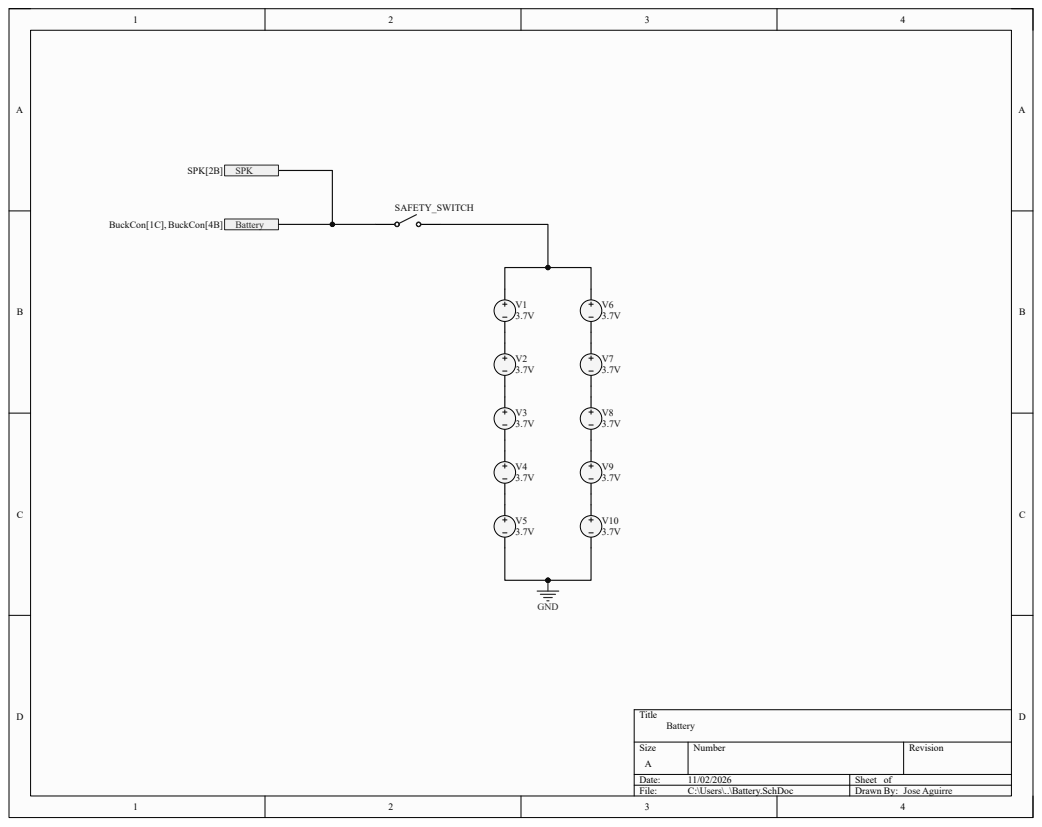
[picture p54: page 4]
Title; Size; Number; Revision; File:; C:\Users\..\Battery.SchDoc; Drawn By:; GND; Battery; Jose Aguirre; SAFETY_SWITCH; SPK[2B] SPK

BuckCon[1C], BuckCon[4B] Battery

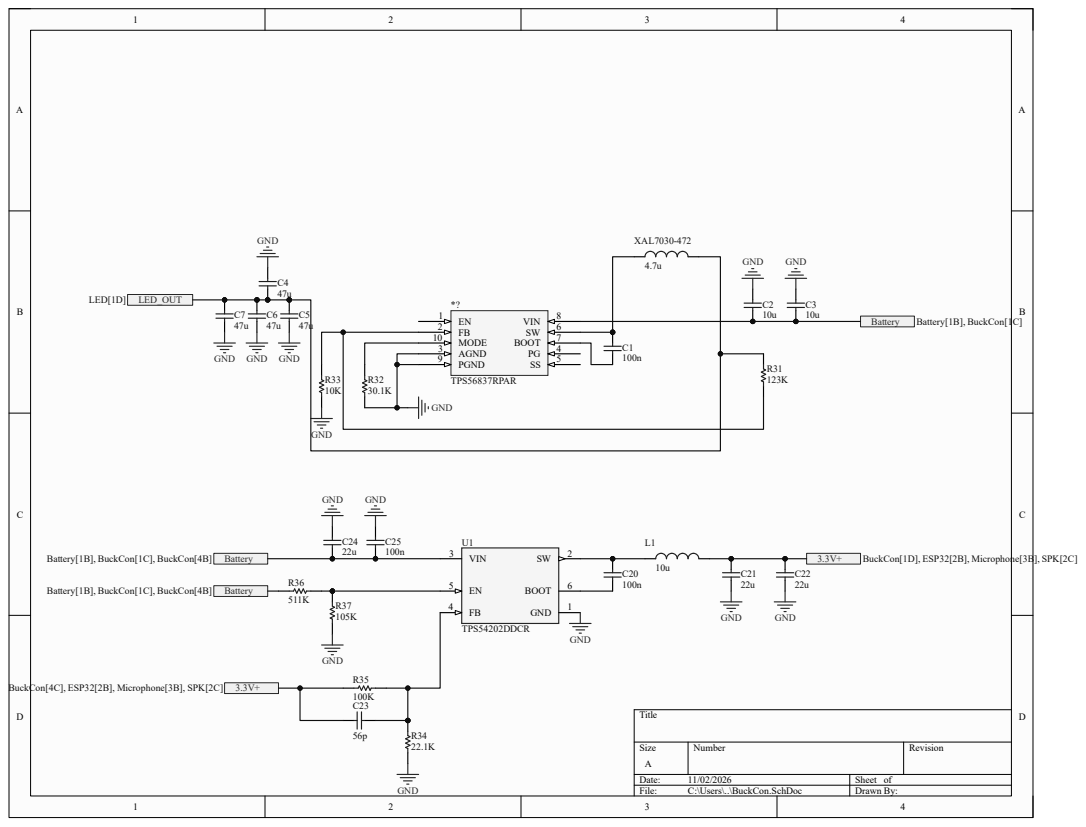
[picture p55: page 5]

Battery[1B], BuckCon[1C], BuckCon[4B] Battery

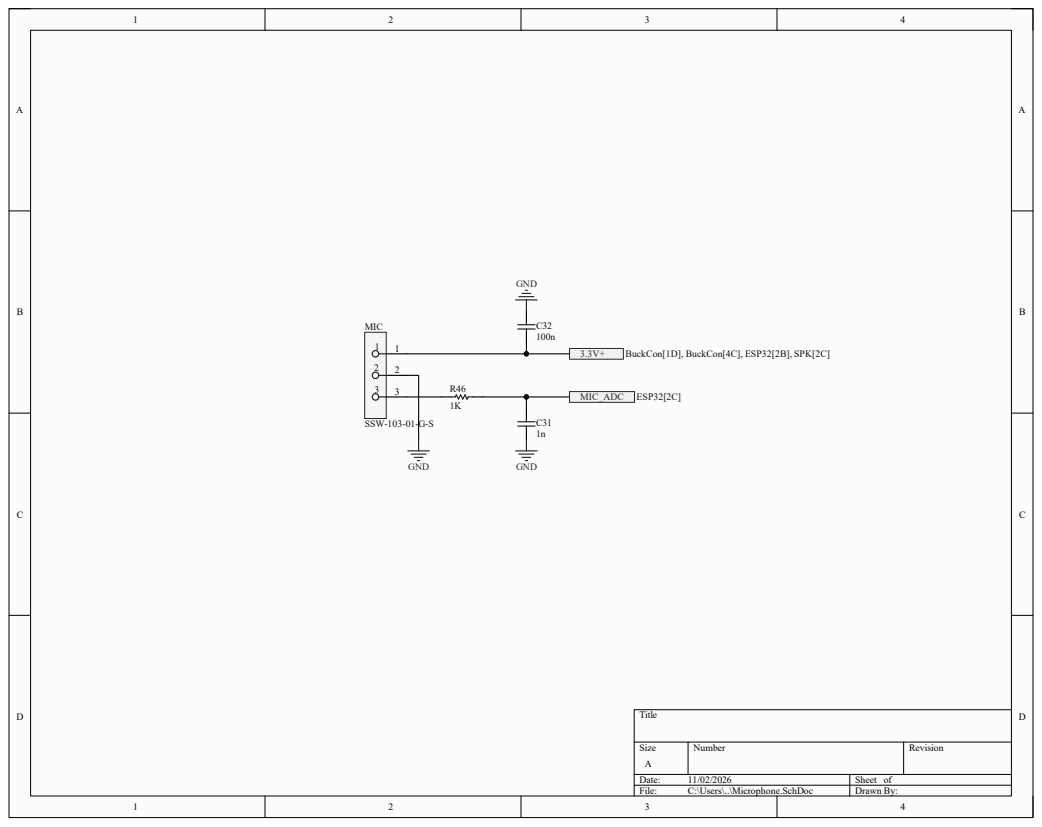
[picture p56: page 6]
Title; Size; Number; Revision; File:; C:\Users\..\Microphone.SchDoc; Drawn By:; MIC; SSW-103-01-G-S; BuckCon[1D], BuckCon[4C], ESP32[2B], SPK[2C]; GND; MIC_ADC ESP32[2C]
