Noah4730/Senior-Design/Design Package/Schematics/Zeus Project Schematics_V2.pdf

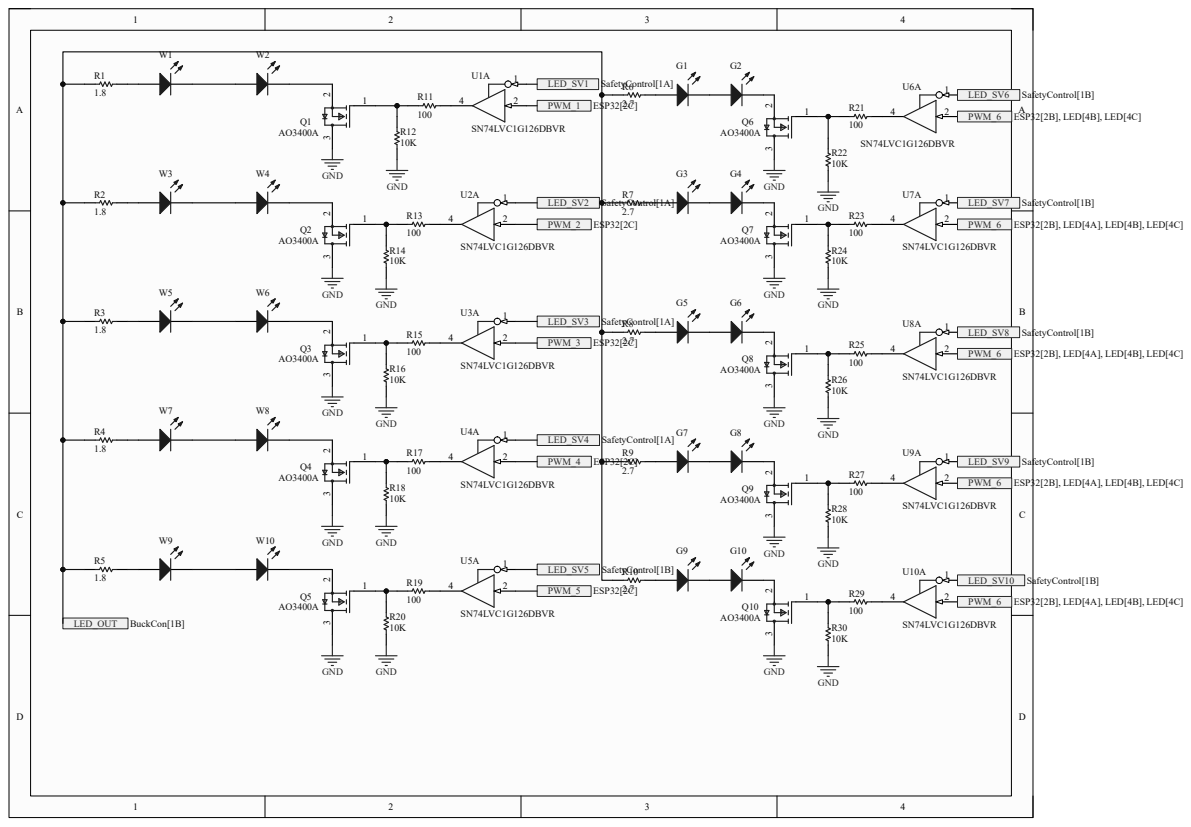
[picture p57: page 1]

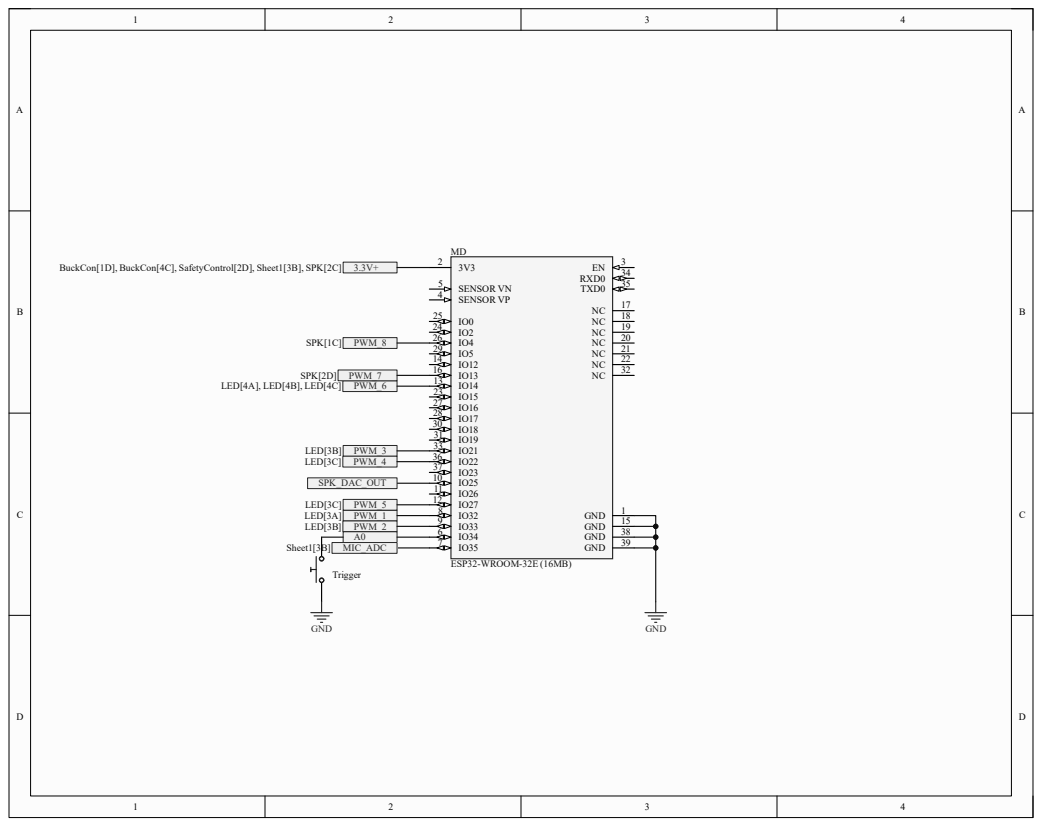
[picture p58: page 2]
SENSOR VN 5 SENSOR VP 4; RXD0; TXD0; GND; ESP32-WROOM-32E (16MB); LED[3A] PWM_1 LED[3B] PWM_2; LED[3B] PWM_3 LED[3C] PWM_4; LED[3C] PWM_5; SPK[2D] PWM_7; SPK[1C] PWM_8; Trigger; SPK_DAC_OUT; Sheet1[3B] MIC_ADC

BuckCon[1D], BuckCon[4C], SafetyControl[2D], Sheet1[3B], SPK[2C] 3.3V+

LED[4A], LED[4B], LED[4C] PWM_6

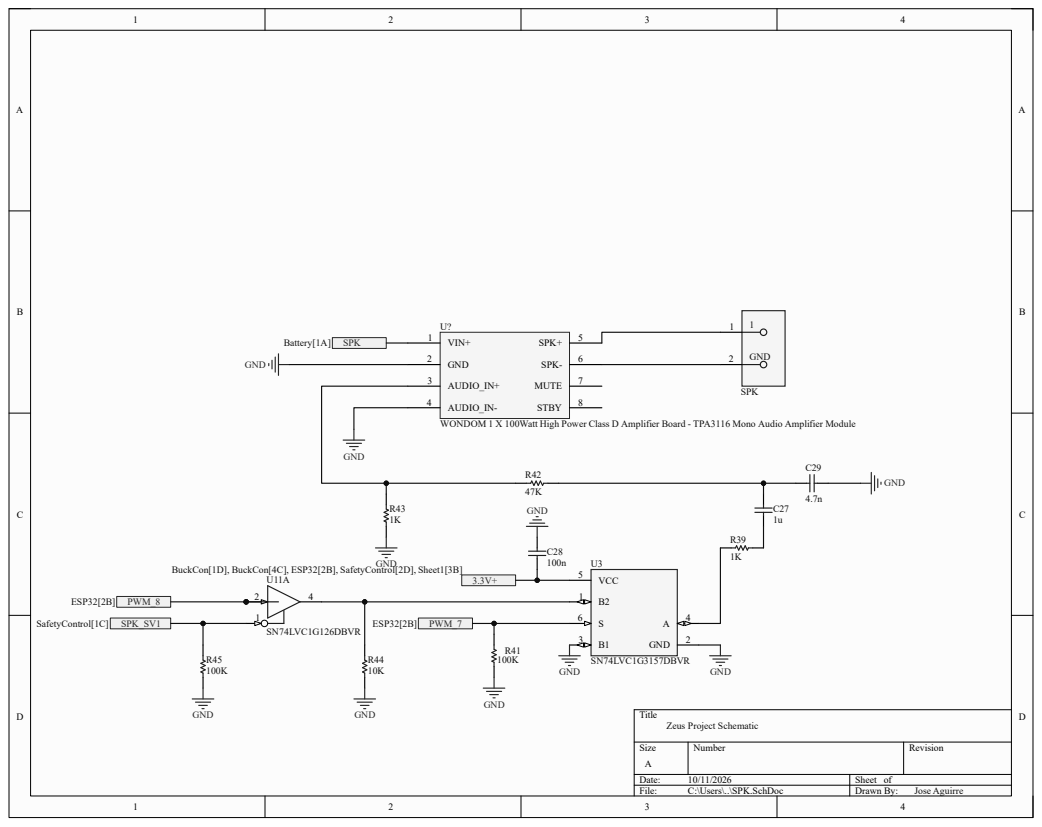
[picture p59: page 3]

WONDOM 1 X 100Watt High Power Class D Amplifier Board - TPA3116 Mono Audio Amplifier Module

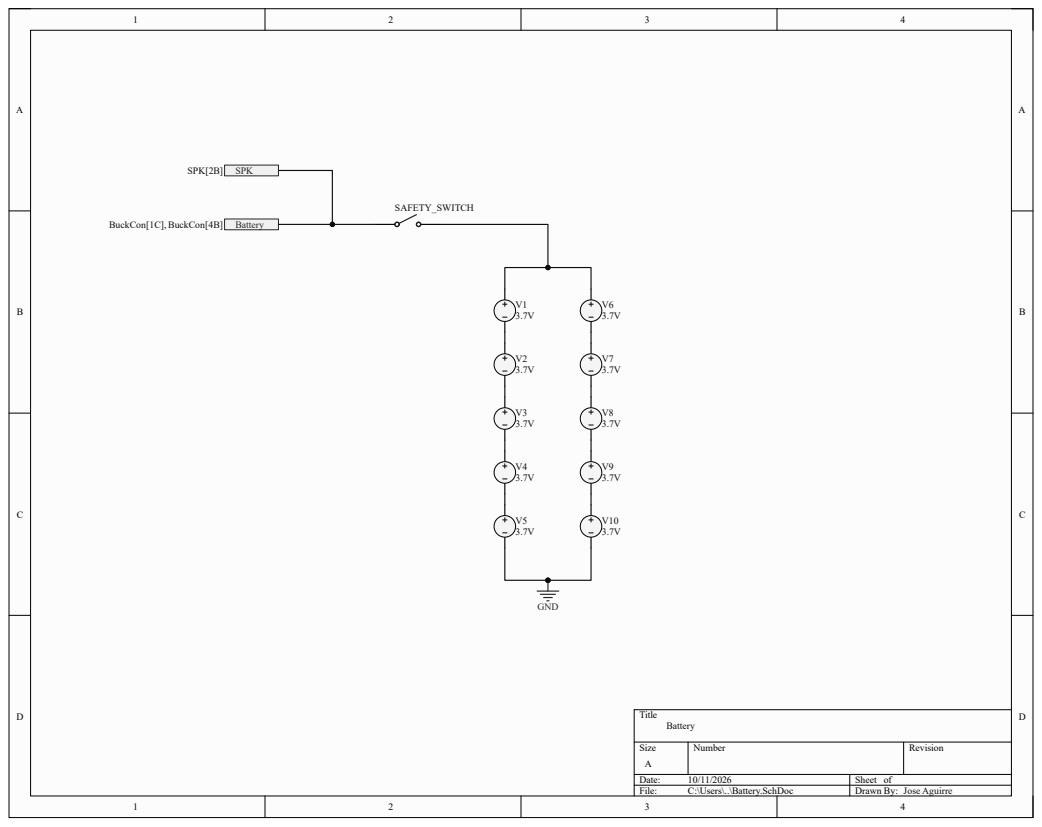
[picture p60: page 4]
Title; Size; Number; Revision; File:; C:\Users\..\Battery.SchDoc; Drawn By:; GND; Battery; Jose Aguirre; SAFETY_SWITCH; SPK[2B] SPK

BuckCon[1C], BuckCon[4B] Battery

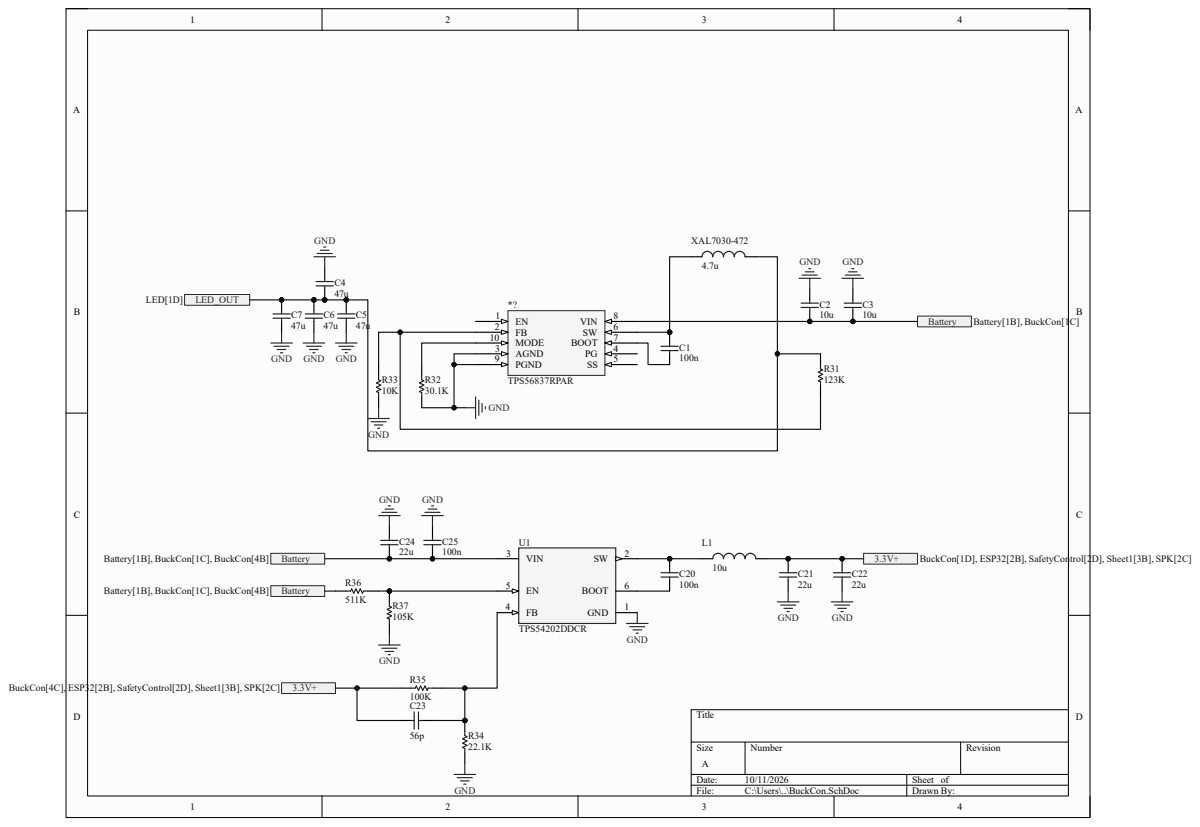
[picture p61: page 5]

Battery[1B], BuckCon[1C], BuckCon[4B] Battery

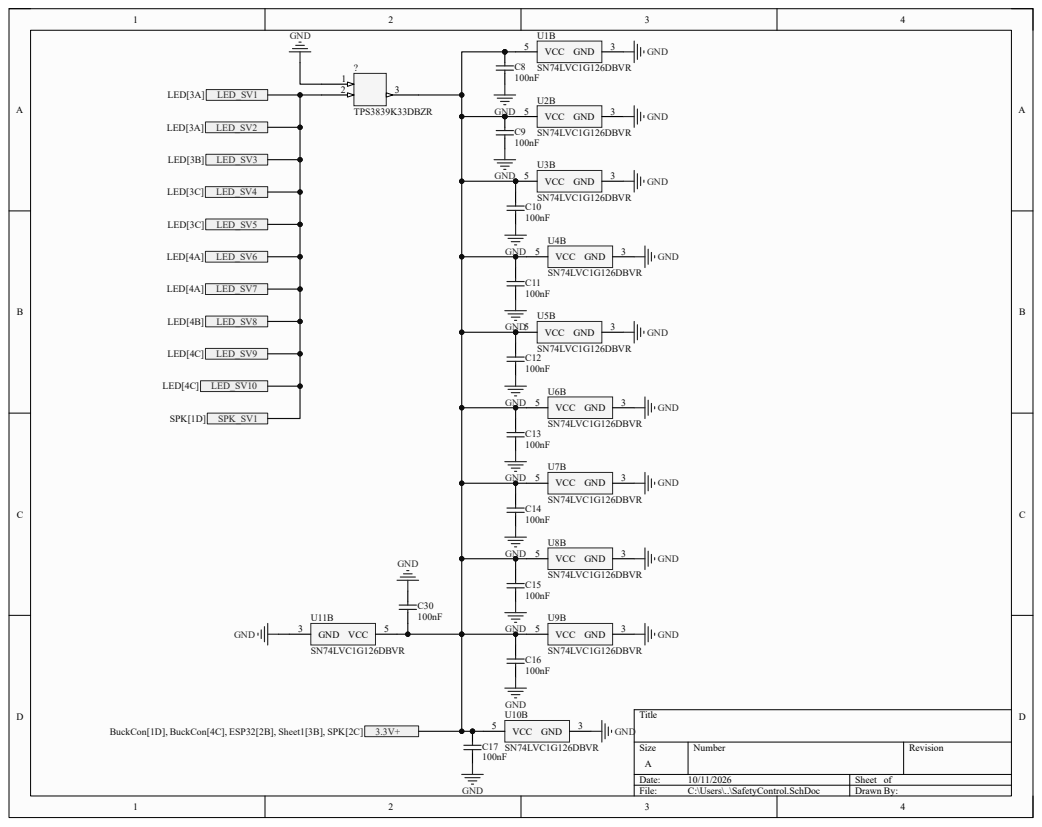
[picture p62: page 6]

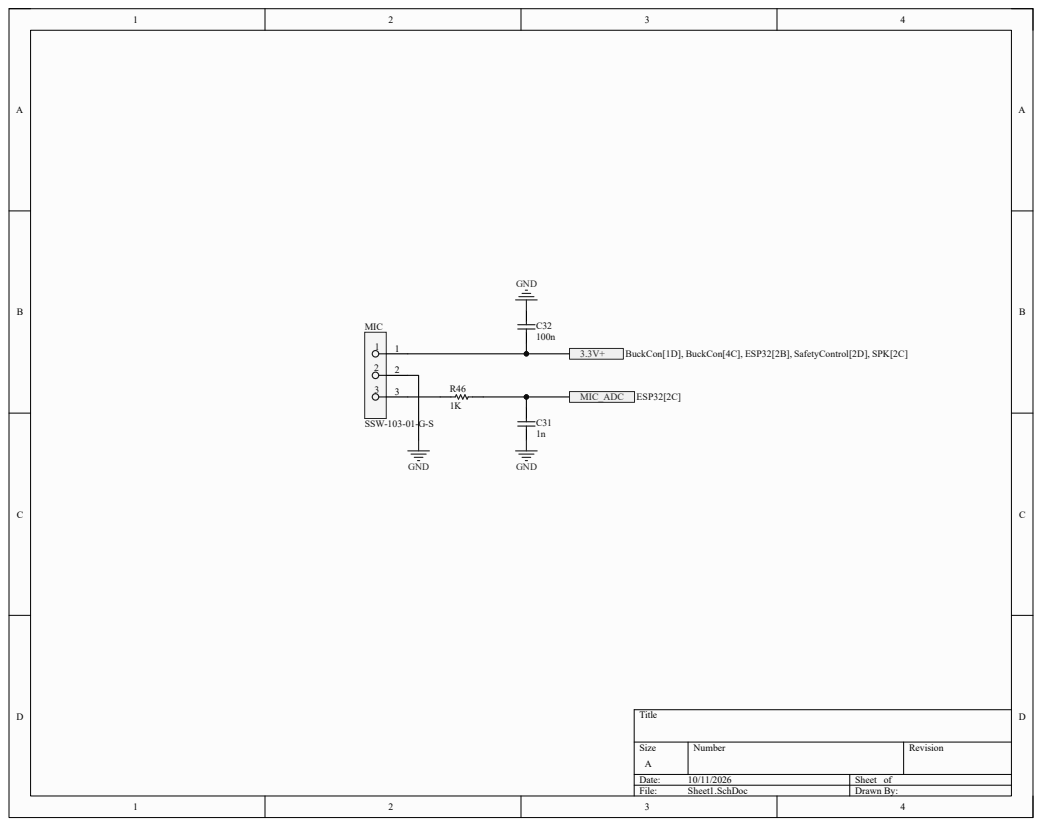
[picture p63: page 7]
Title; Size; Number; Revision; File:; Sheet1.SchDoc; Drawn By:; MIC; SSW-103-01-G-S; BuckCon[1D], BuckCon[4C], ESP32[2B], SafetyControl[2D], SPK[2C]; GND; MIC_ADC ESP32[2C]
