Noah4730/Senior-Design/Design Package/Schematics/White & Green LED (small demo)_JA.pdf

A

1 | 2 | 3 | 4 | 5 | 6

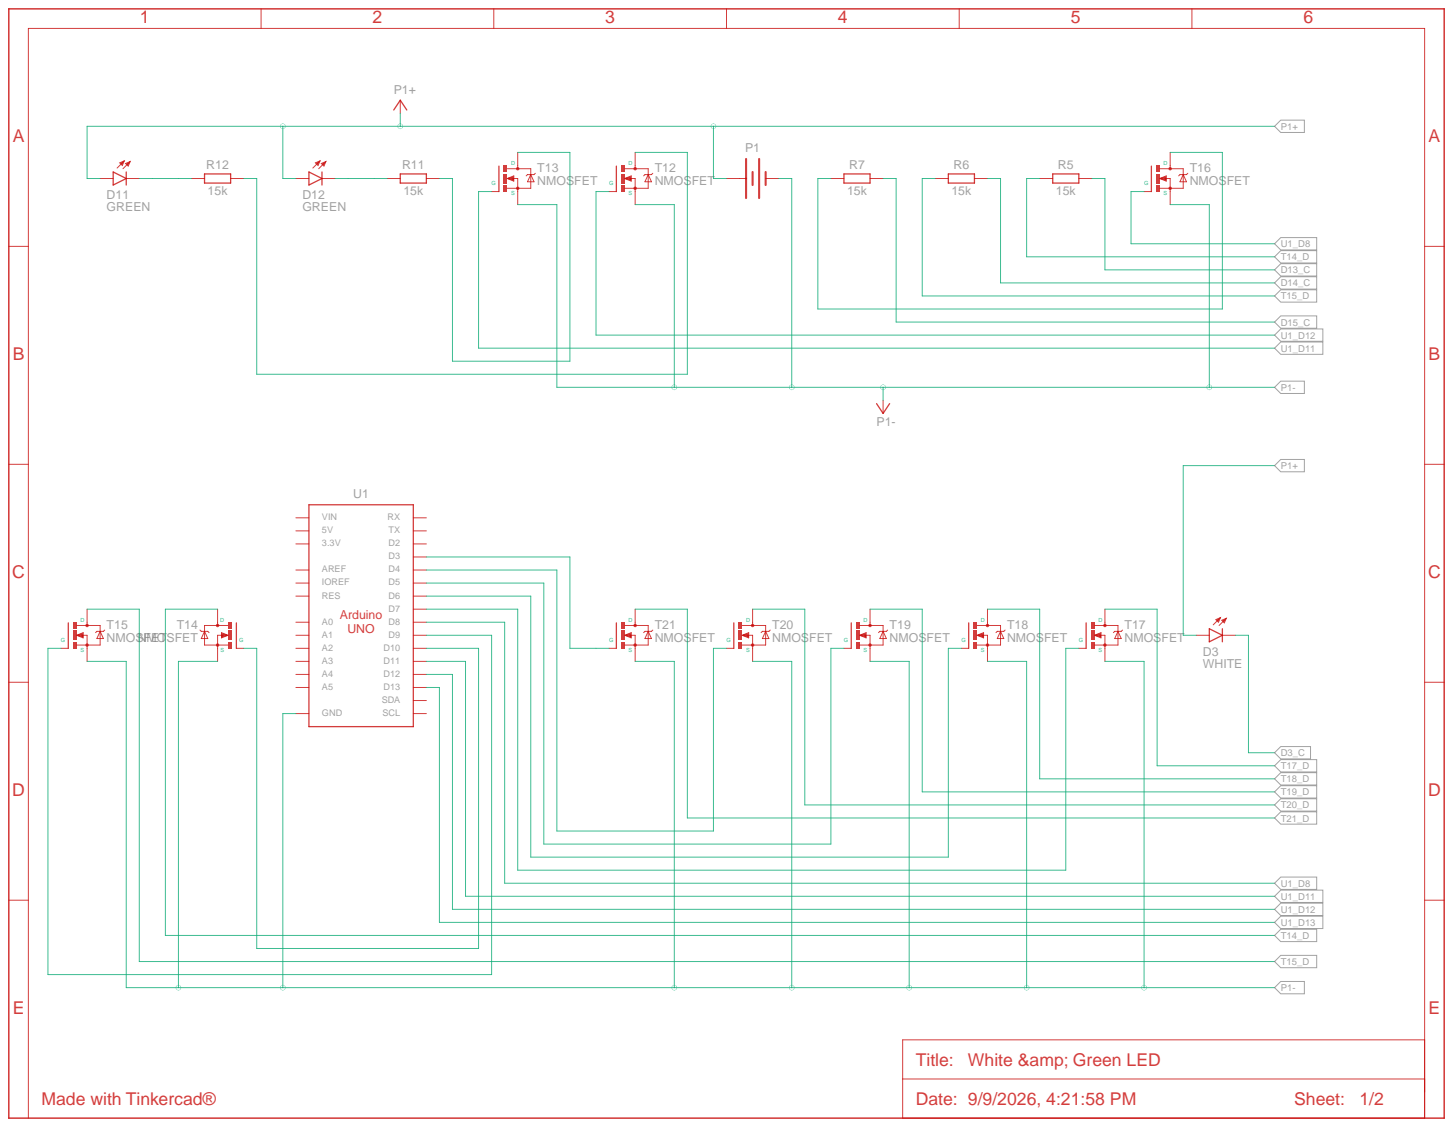
[picture p64: page 1]

Title: White &amp; Green LED

A

1 | 2 | 3 | 4 | 5 | 6

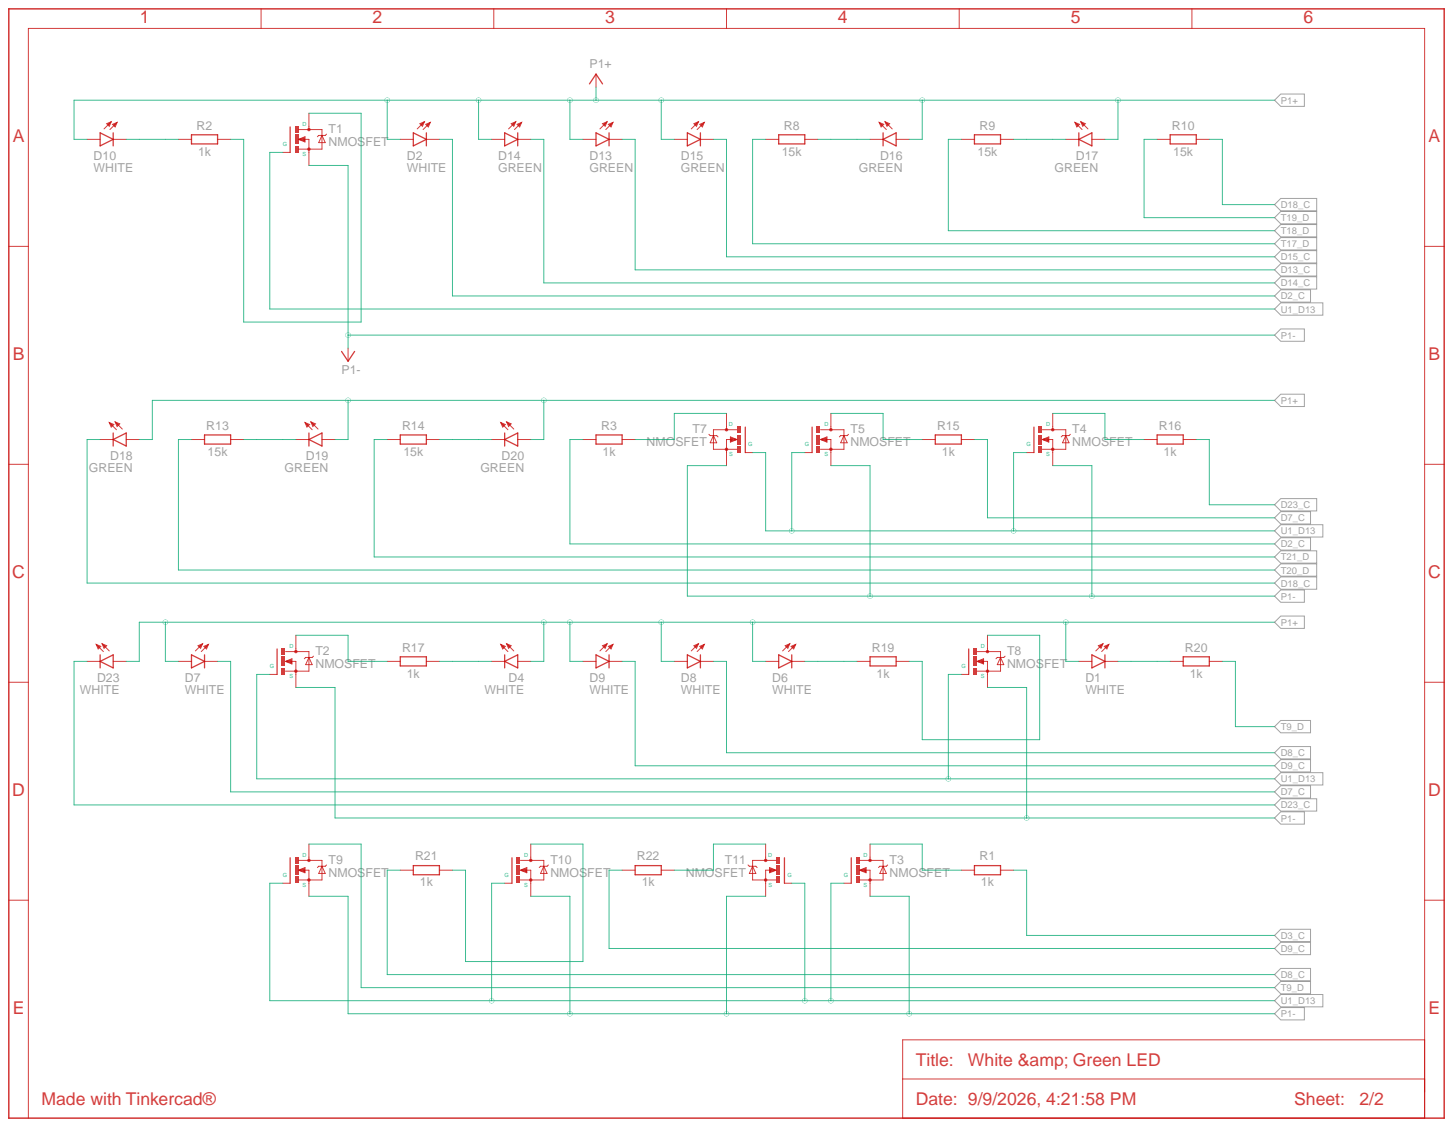
[picture p65: page 2]

Title: White &amp; Green LED
