Noah4730/Senior-Design/Design Package/CAD Drawings/Conceptual Drawings_NJS.pdf

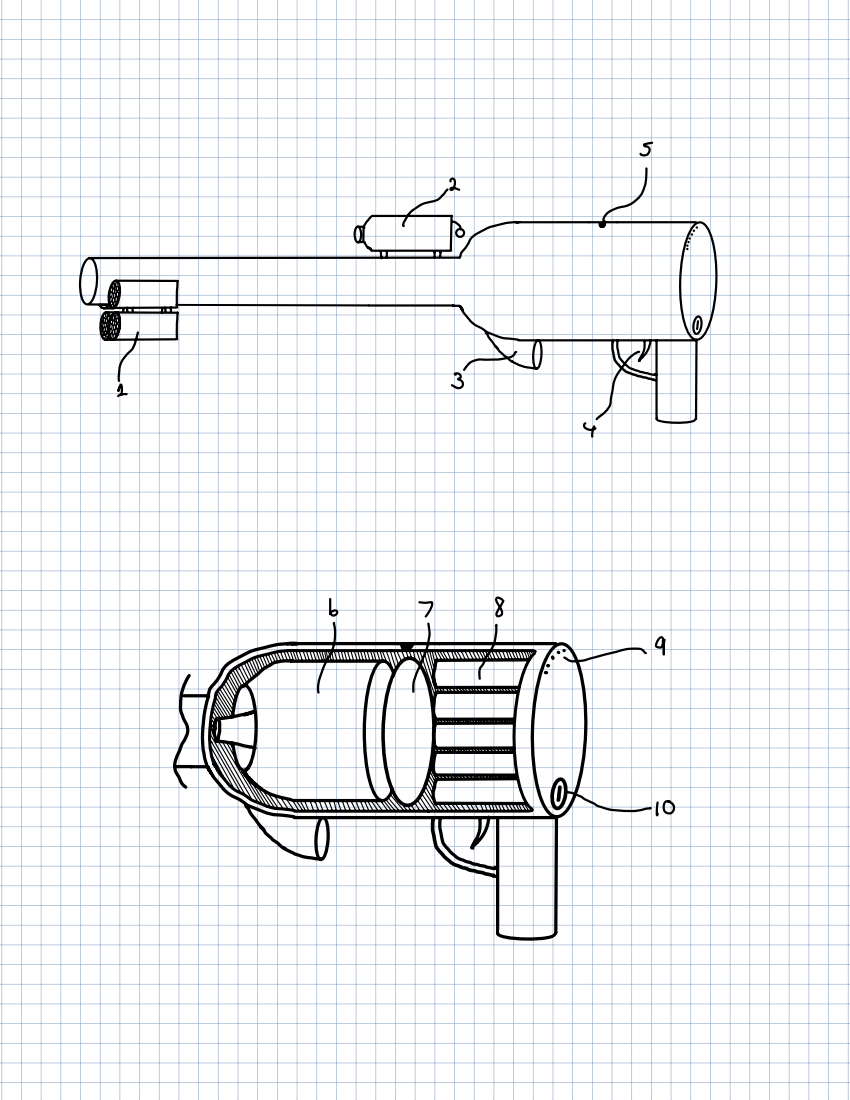
[picture p66: page 1]
Hmmm; Are; Iiiiiiiiiiiiiiii

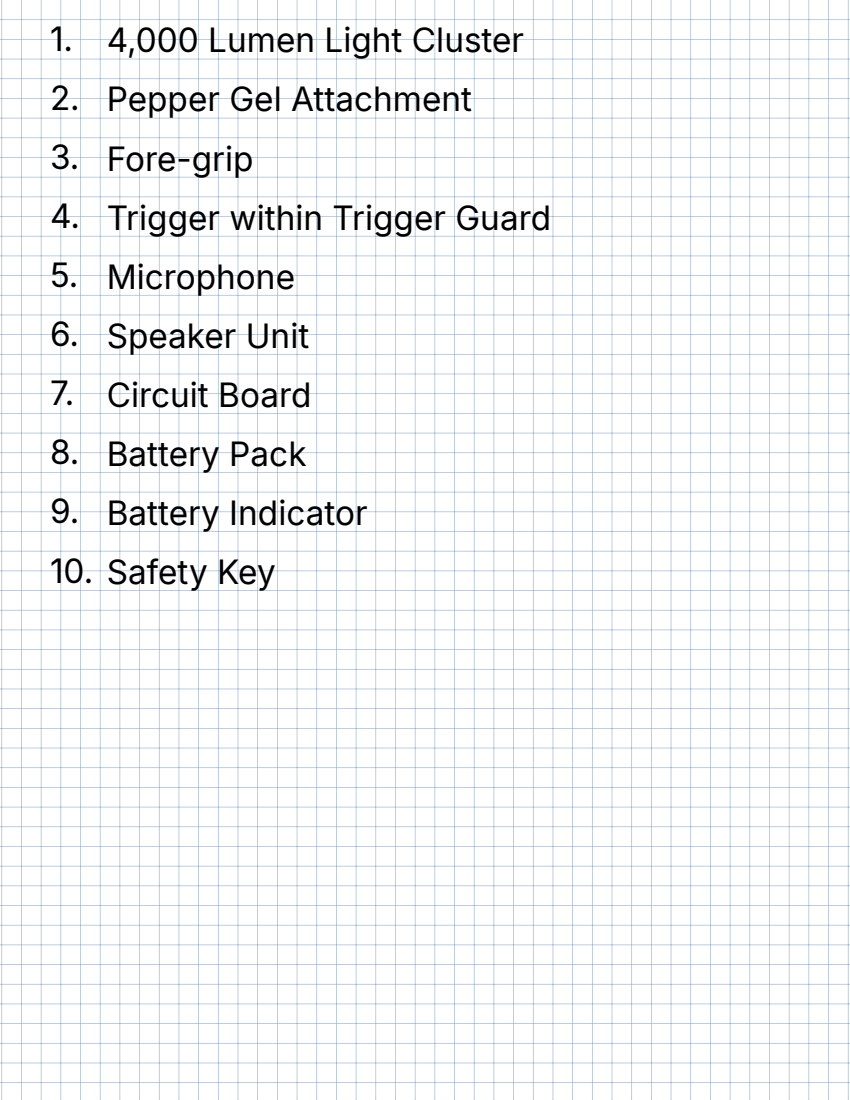
[picture p67: page 2]

1. 4,000 Lumen Light Cluster
2. Pepper Gel Attachment
3. Fore-grip
4. Trigger within Trigger Guard
5. Microphone
6. Speaker Unit
7. Circuit Board
8. Battery Pack
9. Battery Indicator
10. Safety Key
