Noah4730/Senior-Design/Design Package/Schematics/Zeus Project Schematics.pdf

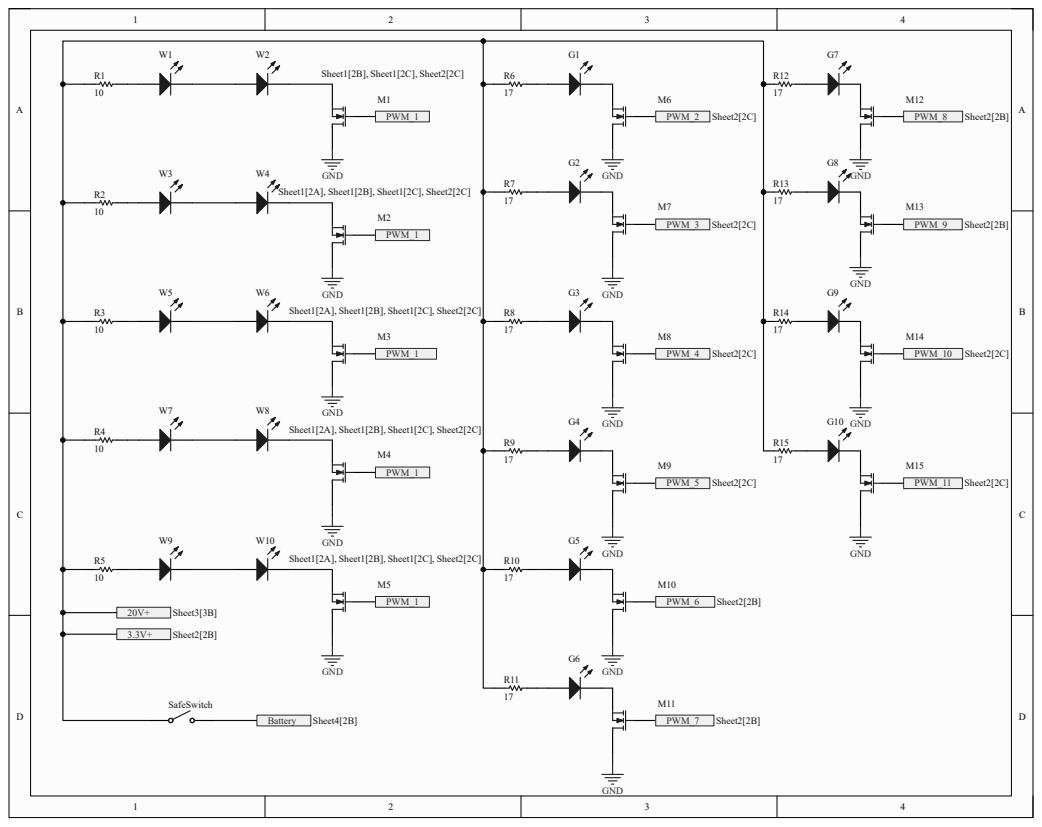
[picture p68: page 1]

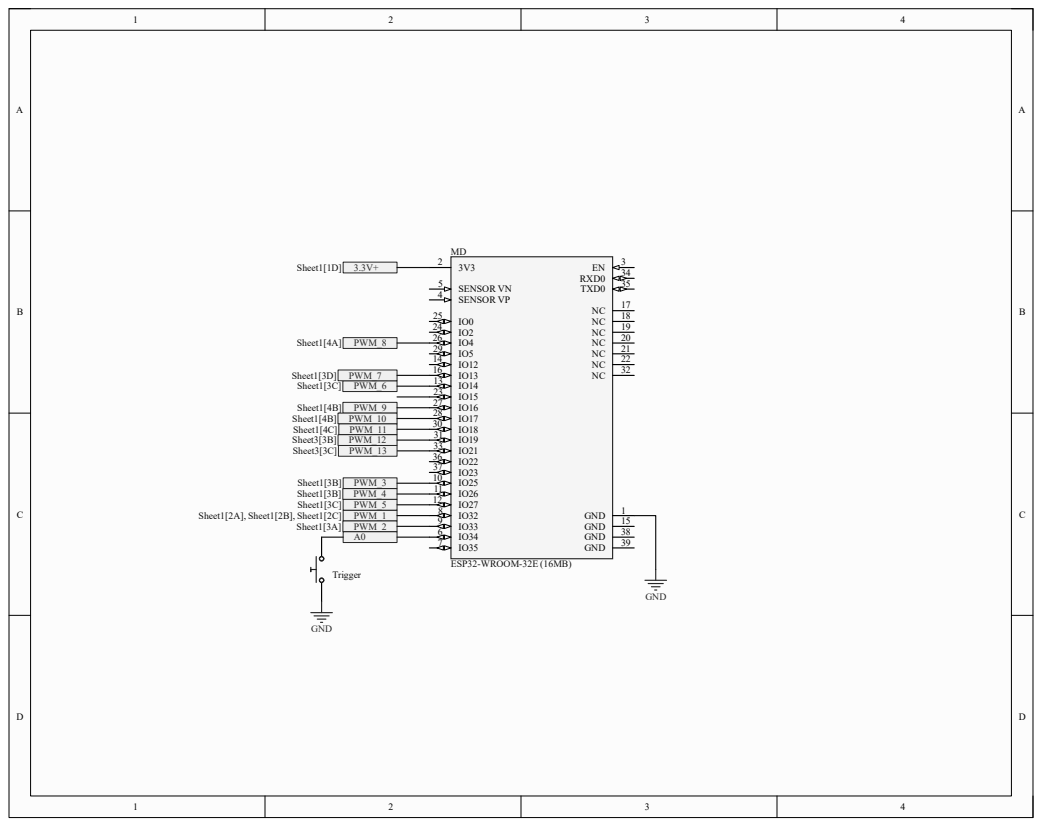
[picture p69: page 2]
SENSOR VN; SENSOR VP; RXD0; TXD0; GND; ESP32-WROOM-32E (16MB); Sheet1[2A], Sheet1[2B], Sheet1[2C] PWM_1 Sheet1[3A] PWM_2; Sheet1[3B] PWM_3 Sheet1[3B] PWM_4 Sheet1[3C] PWM_5; Sheet1[3C] PWM_6; Sheet1[3D] PWM_7; Sheet1[4A] PWM_8; Sheet1[4B] PWM_9 Sheet1[4B] PWM_10 Sheet1[4C] PWM_11; Sheet3[3B] PWM_12; Sheet1[1D] 3.3V+; Trigger; Sheet3[3C] PWM_13

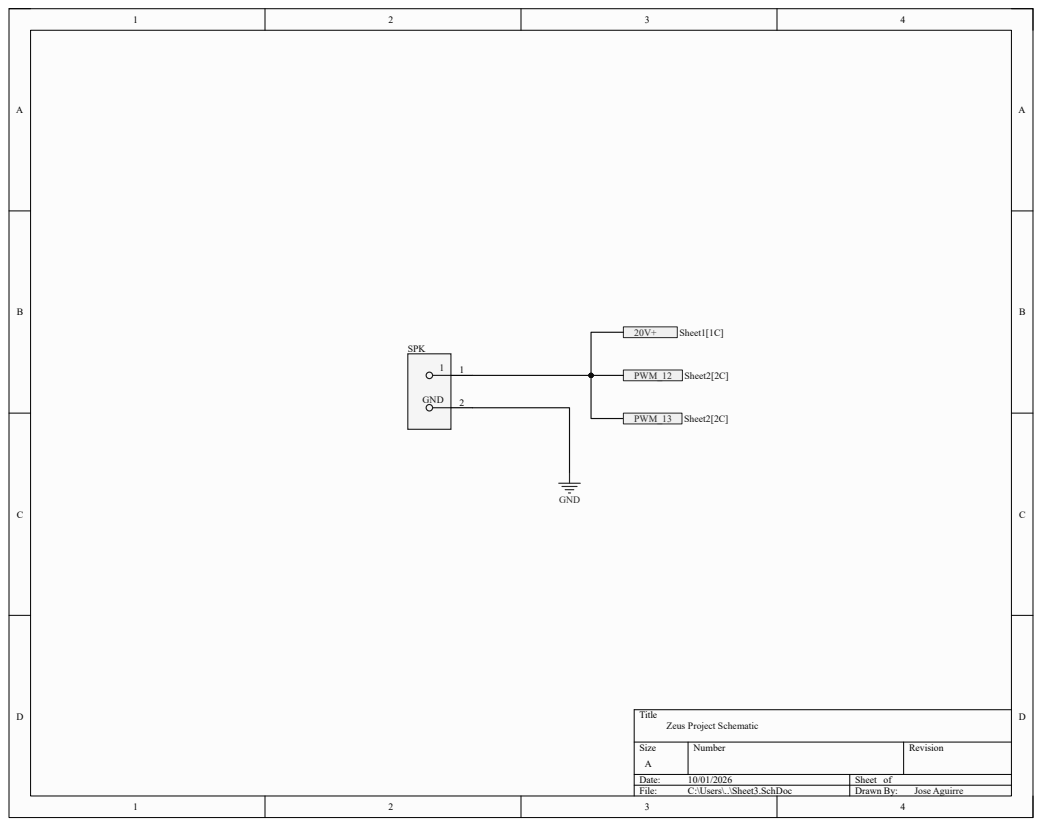
[picture p70: page 3]
Size; Number; Revision; Date:; Sheet of; File:; C:\Users\..\Sheet3.SchDoc; Drawn By:; PWM_12 Sheet2[2C]; GND; SPK; Jose Aguirre; Sheet1[1C]; PWM_13 Sheet2[2C]

Title
Zeus Project Schematic

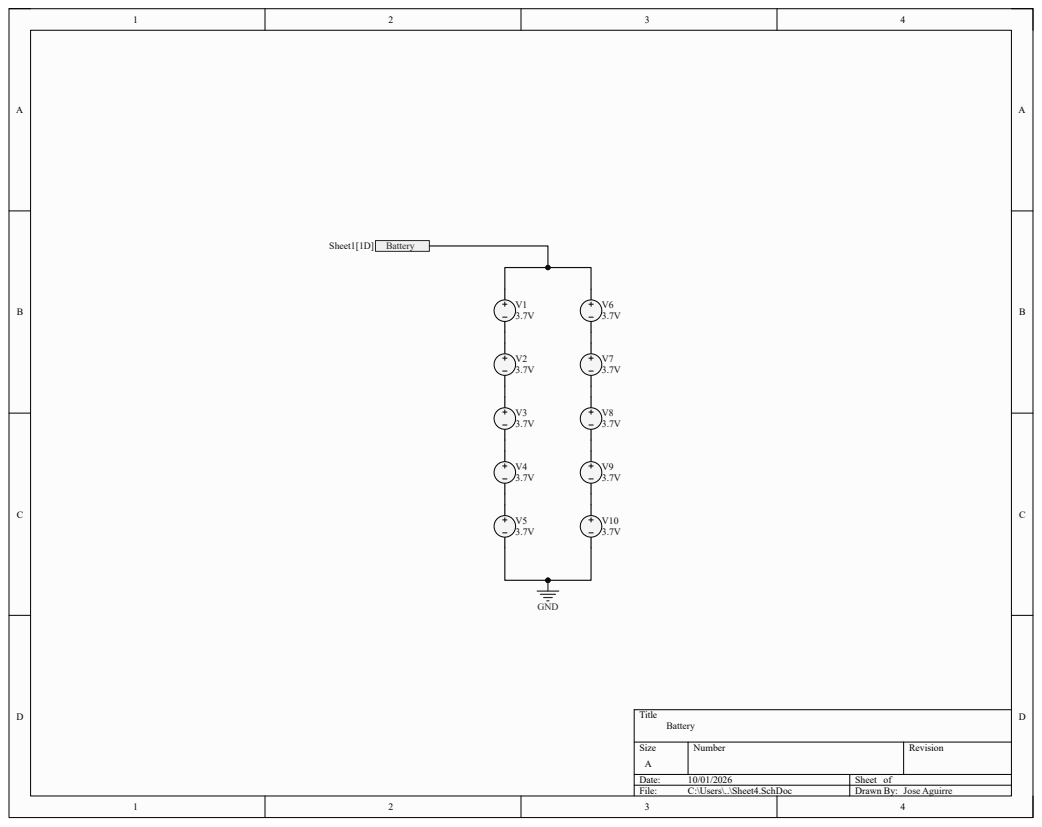
[picture p71: page 4]
Title; Size; Number; Revision; Date:; Sheet of; File:; C:\Users\..\Sheet4.SchDoc; Drawn By:; Sheet1[1D] Battery; GND; Battery; Jose Aguirre
