Noah4730/Senior-Design/Design Package/Software/Current_Complete_Product/esp_main/variables.h

#pragma once

#include <Arduino.h>
#include <SPI.h>
#include <SD.h>

/*
  Christina Walker: safety checks and data logging functions
  Noah Schatz: light and sound control functions
*/

// const int chipSelect = 10;
// File logFile;

// const int greenPins[] = {16, 17, 18, 19, 21};
// Arduino uses GPIO numbers, not module pin numbers. Module pins are noted on each line.
const int greenPins[] = {32, 23, 22, 21, 19};     // module pins 8, 37, 36, 33, 31
// const int whitePins[] = {22, 23, 25, 26, 27};
const int whitePins[] = {18, 17, 16, 14, 13};     // module pins 30, 28, 27, 13, 16
const int numGreenPins = 5;
const int numWhitePins = 5;
// const int speakerPin = 32;
const int speakerPin = 25;                        // module pin 10
// const int volumePin = 33;
const int volumePin = 26;                         // module pin 11
// const int triggerPin = 34;
const int triggerPin = 34;                        // module pin 6 (input only)
// const int soundSensorPin = 35;
const int soundSensorPin = 35;                    // module pin 7 (input only, ADC1)
const int LVmin = 20;
const int LVmax = 80;
const int HVmin = 150;
const int HVmax = 255;
const int RMSout = 160;
const int minimumOffDuration = 250;                   // Speaker off interval between high volume phases
const int maximumOffDuration = 750;
const int minimumHVDuration = 500;
const int maximumHVDuration = 1500;
const int minimumFrequency = 3000;
const int maximumFrequency = 10000;
const int frequencyOffset = 3000;
const int minimumFlicker = 900;
const int maximumFlicker = 1200;
const int minimumPause = 100;
const int maximumPause = 200;
const float soundLimitDb = 130.0;
const float soundReleaseDb = 105.0;
const int requiredQuietReadings = 20;
const unsigned long micWindow = 50;


const int whitePatternSteps = 5;
const int whitePatterns[3][whitePatternSteps][3] = {         // White flicker patterns for modes 1-3
  {{1, 0, 0}, {3, 0, 0}, {5, 0, 0}, {2, 0, 0}, {4, 0, 0}},   // star, one pin at a time
  {{1, 2, 0}, {4, 3, 0}, {5, 1, 0}, {2, 3, 0}, {5, 4, 0}},   // two pins at a time
  {{1, 2, 3}, {3, 4, 5}, {5, 1, 2}, {2, 3, 4}, {4, 5, 1}}    // three pins at a time
};

inline int freqWhite = 40;
inline int freqGreen = 35;
inline int greenBrightness = 255;                      // Brightness for all green pins (0-255)
inline int whiteBrightness = 255;                      // Brightness for all white pins (0-255)
inline int flickerMode = 1;                            // 0 = all at once, 1 = star, 2 = two at a time, 3 = three at a time
inline int whiteStep = 0;                              // Current flash in the white flicker pattern
inline int rotSpeed = 28;
inline int speakerFreq = 1000;
inline int sweep = 50;
inline int volumeLevel = 0;
inline int volumePhase = -1;                           // -1 = trigger off, 0 = speaker off interval, 1 = high volume
inline int state = 0;
inline int greenIndex = 0;
inline unsigned long lastTime1 = 0;
inline unsigned long lastTime2 = 0;
inline unsigned long lastTime3 = 0;
inline unsigned long volumePhaseStart = 0;
inline unsigned long volumePhaseDuration = 0;
inline unsigned long outputTime = 0;                   // Total ms counted in the running RMS
inline float outputSquareSum = 0;                      // Sum of volumeLevel^2 * ms counted in the running RMS
inline bool soundLimited = false;                      // true = high volume held to the quieter half of the high range
inline int quietReadings = 0;                          // Consecutive high volume readings at or below soundReleaseDb
inline float micReadingDb = 0;
inline unsigned long lastMicWindow = 0;
inline int micMin = 4095;
inline int micMax = 0;
inline long micSum = 0;
inline int micCount = 0;                               // Number of mic samples in the current window

// Christina Walker - sound safety controller (safety_CW.cpp)
inline int safetyGain= 255;
// const int micPin= 34;       // analog input pin the microphone is wired to
const int micPin= soundSensorPin;   // same mic as soundSensorPin (GPIO35, module pin 7)

//safety limit placeholders
// if measured sound goes above this level, speaker output should be reduced
// const float soundLimitDb= 130.0;   // immediate threshold (placeholder)

//exposure time is tracked when the sound is at/above this dB level
const float exposureLimitDb= 110.0;  //lower threshold where exposure time is recorded (placeholder)

//maximum accumulated exposure time at/above exposureLimitDb
//currently placeholder and will be replaced with approved value
const unsigned long maxExposureTime= 30000UL;  //30 seconds- max cumulative time allowed at/above exposureLimitDb before shutdown (placeholder)

//timing

inline unsigned long lastSampleTime= 0;  //timestamp (ms) of the last microphone reading. used for the 50ms sample timer

//how often microphone is checked
const unsigned long sampleInterval= 50;  //sampling period (ms). Also the time slice added to exposureTime each loud sample

inline unsigned long lastExposureTime= 0;  //timestamp used to calculate actual elapsed exposure time

//counts consecutive readings at/above the exposure threshold
inline int highReadingCount= 0;
const int requiredHighReadings= 3;  //number of consecutive high readings required before exposure is accumulated

//tracks whether the immediate sound-limit event has already been logged
inline bool soundLimitEventLogged= false;

//total exposure time
inline unsigned long exposureTime= 0;  //running total (ms) of time spent at/above exposureLimitDb since the system was last activated

//system state
inline bool safetyShutdown= false; //latches TRUE once maxExposureTime is exceeded. Stays true (keeps output reduced) until trigger goes LOW

//speaker volume control
const int fullGain= 255;
const int safetyGainStep= 5;

// Christina Walker - battery indicator (battery_CW.cpp)
const int batteryPin=36; //battery voltage input: GPIO36 / SENSOR_VP, module pin 4 (ADC1, input only) - placeholder, confirm wiring
// const int buzzerPin=33;  //low battery buzzer (ESP32 GPIO number- placeholder pin)
const int buzzerPin=33;  //low battery buzzer: GPIO33, module pin 9 - placeholder, confirm wiring

// scaling from the divider
const float dividerRatio=(100000.0+12000.0)/12000.0;

// battery voltage that counts as 20% left (full is about 21 V, nominal about 18.5 V)
// const float lowBatteryVoltage=17.5;
const float lowBatteryVoltage=16.5;

// the reading is checked once a second, and the warning only starts after several low
// readings in a row, so one dip (for example when the speaker draws power) does not trigger it
inline unsigned long lastCheck=0;                  //timestamp (ms) of the last battery check
const unsigned long checkInterval=1000;     //time (ms) between battery checks
inline int lowReadingCount=0;                      //how many checks in a row were below the threshold
const int requiredLowReadings=5;            //low readings in a row needed before warning

inline unsigned long lastWarning=0;          //timestamp (ms) of the last time we sounded the buzzer
const unsigned long warningInterval=5000;   //minimum gap (ms) between buzzer warnings= 5 seconds
