Noah4730/Senior-Design/(commit log)

2026-09-18 Move Green-LED-Strobe_NJS.ino to Light Setup directory
2026-09-18 Move White-LED-Strobe_NJS.ino to Light Setup directory
2026-09-18 Rename Design Package/Software/Light_Log_Without_SD/Light_Log_Without_SD.ino to Design Package/Software/Current_Complete_Product.ino
2026-09-30 Modify switch statement with AI-generated comments
    Updated switch statement to include AI-generated comments.
2026-10-01 removed unnecessary files from the repository to streamline the project and reduce clutter. These files were either outdated or no longer relevant to the current development phase.
    [Sound_Log_With_SD_Comments_CW.ino, Sound_Log_Without_SD_Comments_CW.ino]
2026-10-01 Integrated Speaker_Setup code into Current_Complete_Product.ino
2026-10-02 Fix formatting issues in Current_Complete_Product.ino
    [Current_Complete_Product.ino]
2026-10-02 Rename Design Package/Software/Current_Complete_Product.ino to Design Package/Software/Current_Complete_Product/Current_Complete_Product.ino
2026-10-02 Rename Design Package/Software/Light Setup/Green-LED-Strobe.ino to Design Package/Software/Light Setup/Green-LED-Strobe/Green-LED-Strobe.ino
2026-10-02 Rename Design Package/Software/Light Setup/White-LED-Strobe.ino to Design Package/Software/Light Setup/White-LED-Strobe/White-LED-Strobe.ino
2026-10-02 Rename Test Cases_SVV-03_SLV-01-03_NJS.xlsx to Test Spreadsheets/Test Cases_SVV-03_SLV-01-03_NJS.xlsx
    [Test Cases_SVV-03_SLV-01-03_NJS.xlsx]
2026-10-16 final led edits and finally commiting the completed test bench file.
2026-11-06 Rename Zeus Project Schematics.pdf to Zeus Project Schematics_JA.pdf
2026-11-06 Rename Zeus Project Schematics_V2.pdf to Zeus Project Schematics_V2_JA.pdf
2026-11-06 Create Battery Indicator
2026-11-13 changed low volume phases to turn off instead to save on battery
2026-11-13 Update Battery Indicator
2026-11-13 Update and rename battery_indicator_2.0.ino to sound log serial
2026-11-13 Pin reassignments
